patmakesapps/humalien/exports/plate3/forehead_casing_x1.stl

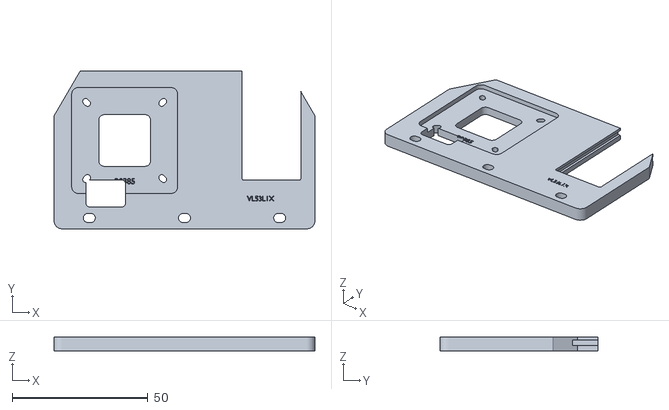
[picture p1: CAD file, 2026-08-13]
exports/plate3/forehead_casing_x1.stl
96.0 x 58.0 x 5.00
