patmakesapps/humalien/exports/plate4/ear_hub_l_x1.stl

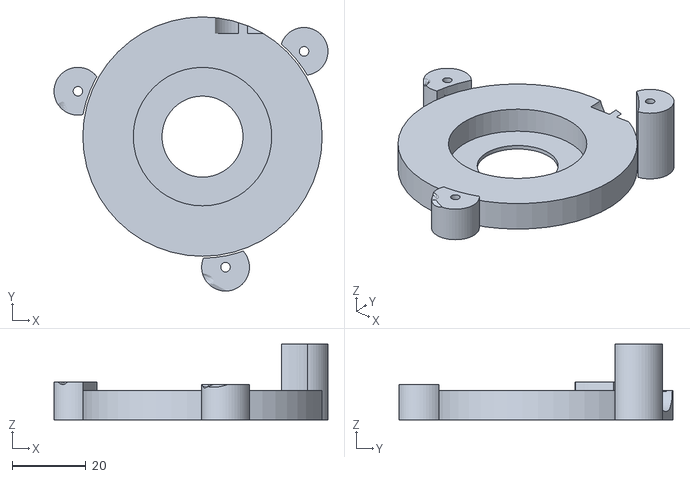
[picture p2: CAD file, 2026-08-14]
exports/plate4/ear_hub_l_x1.stl
74.4 x 74.5 x 20.6
