patmakesapps/humalien/exports/plate3/pca9685_mount_x1.stl

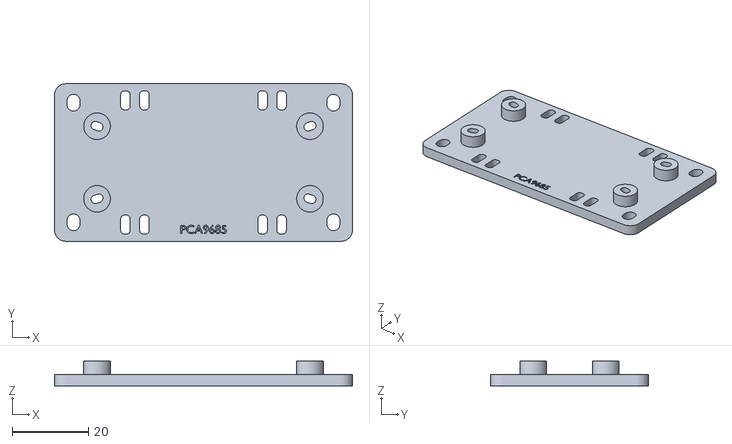
[picture p3: CAD file, 2026-08-13]
exports/plate3/pca9685_mount_x1.stl
78.2 x 41.4 x 6.50
