patmakesapps/humalien/(list of files, cad)

Other CAD files:
exports/plate4/ear_hub_r_x1.stl
