patmakesapps/humalien/cad/head_mounts.py

"""Give every part in the head something to bolt to, and build the parts the
head itself needs.

Run inside Blender AFTER head_style.py has built HEAD_CYBORG and HEAD_SKIN,
and after fit_layout.py has placed FIT_Assembly. head_style.py must have been
exec'd into the same namespace, because `S` and `eye_axis` come from it:

    ns = {}
    for f in ("head_style", "head_mounts"):
        exec(compile(open(r"C:\\humalien\\humalien\\cad\\%s.py" % f).read(),
                     f, "exec"), ns)
        ns["build"]() if f == "head_style" else ns["build"](ns["S"],
                                                            ns["eye_axis"])

Before this pass every part in the fit study was floating. The layout was
honest about it - "the skull-side fixings on the parts are slotted precisely
because these numbers are guesswork until a head shell exists" - but a head
shell exists now, so the guessing is over.

The rule this file follows
--------------------------

**A screw is only worth drawing if a hand can reach it.** That one test
decides most of what follows, and it is why head_split.py exists: with the
face off, the cranium is an open bowl and every fixing below is reachable
from the front. Nothing here asks a screwdriver to turn a corner.

Two patterns, and the choice between them is about which side of the skin
the hand is on:

    boss      A post standing on the shell's inner surface, reaching out to
              meet the part's own mounting face; the screw goes in from the
              part's side. Used where the part is near a wall and the inside
              is open - the PCA9685 on the rear wall, the cable anchors, the
              forehead casing off the brow.

    through   A clearance hole in the skin, with the part behind it carrying
              the thread, so the screw head sits on the outside of the head.
              Used where a part cannot be reached from inside once fitted -
              the ear hubs, the tray rails. Visible fasteners are not a
              compromise: every reference photo is covered in them.

No boss length is guessed. Each is raycast from the part's fixing point to
the shell's inner surface, so the post is exactly as long as the gap it
crosses, and a re-run after a styling change re-measures instead of
re-guessing. The same trick shapes parts: build a lug deliberately too long,
subtract the head, and it comes back trimmed to the skin's curvature.

The parts this file builds
--------------------------

`ear_hub`       The port module the fit study left as PROXY_ear_hub_TBD: a
                Ø65 plug carrying the NeoPixel ring in a recess, the grille
                through its middle, the speaker on two posts behind it, and
                three arms reaching out to the shell.

                It fits from INSIDE, and it has to. The head's surface around
                the ear varies by 20 mm in depth across the Ø66 port, so
                there is no flat collar that could ever sit on that skin; and
                any arm long enough to reach the shell is wider than the bore
                it would have to pass through. Once the head splits, fitting
                from inside costs nothing - the cranium is an open bowl.

`eye_bezel`     Closes the 4.5 mm annulus between the Ø41 socket and the Ø32
                eyeball. Without it the eye reads as a ball dropped down a
                hole; with it, as an eye in a socket. Its front face is set
                from the shallowest point on the socket rim, measured, since
                the skin over the socket is not flat.

                A removable forehead panel was built here too and then
                deleted. The reasoning is kept in head_style.S under
                `brow_band`: the forehead drops 20 mm from the centreline to
                the temple across the width that panel wanted, and on a
                surface that steep its landing pads sit behind the skin in
                the middle and break out through it at the edges. The brow
                band is a groove now, and the camera is serviced by taking
                the face off, which is four screws either way.

`tray_rail`     A ledge each side for the Pi 5 tray. The tray's four slotted
                fixings sound like four bosses and cannot be: at tray height
                the skull is 120 mm across and the nearest floor is 100 mm
                below, so a post under a corner would be a 100 mm spike.
                Ledges off the side walls are what the geometry allows,
                and eye_mech's pi5_tray gained four side fixings to land on
                them.

Booleans are batched and baked: everything being added to the shell is
joined and unioned once, everything being cut is joined and subtracted once,
and the file saves between stages. A live stack of booleans over this sculpt
has taken Blender down before. They run on the MANIFOLD solver - see
`boolean` for the three separate ways EXACT failed on this shell.

Two traps in here cost more time than the geometry did, and both are silent:
a boolean whose cutter object the depsgraph has not seen evaluates against
nothing, and a boolean on an object in a hidden collection bakes the mesh it
already had. Neither raises. `_bake` and `_ensure_evaluable` exist for them.
"""

import bpy
import bmesh
import math
from mathutils import Matrix, Vector
from mathutils.bvhtree import BVHTree

COLL = "MOUNT_Parts"
HEAD = "HEAD_CYBORG"
SKIN = "HEAD_SKIN"
SOLID = "HEAD_SOLID"    # closed volume of the head; nothing may leave it
ZONE = "MOUNT_ZONE"     # where mount geometry is allowed to exist
ZONE_INSET = 1.5        # mm below the outer skin the zone stops
ARM_MIN = 6.0           # mm of reach below which an arm is a stub, not a boss
# The root flare under each ear-hub boss. Ø23 down to Ø13 over 5.0 mm is a
# 45 degree wall - self-supporting - and it takes the bonded cross-section
# where the boss meets the Ø65 plug from 21.5 mm2 to 116.3 mm2. 5.0 is under
# plug_t, so the flare stays inside the plug's own thickness and can never
# reach the front face, show in the ear port, or foul the NeoPixel ring.
# Ø23 is set by the 15.75 mm from the 290 degree boss to the z-24 blind
# thread, not by taste. See cad/ear_hub_repair.py for the measurements.
ARM_FLARE_D = 23.0
ARM_FLARE_H = 5.0

M = dict(
    m3_free   = 3.4,      # clearance for an M3
    m3_pilot  = 2.6,      # self-tapping pilot in PLA for an M3
    m2_pilot  = 1.7,
    boss_d    = 10.0,
    wall      = 4.0,

    ear       = dict(y=95.0, z=204.0, bore=66.0,
                     plug_d=65.0,        # 0.5 clearance in the Ø66 bore
                     plug_t=8.0,
                     face_x=47.5,        # outer face, behind the deepest rim
                     ring_od=37.6,       # 36.83 + fit
                     ring_t=6.9,         # 6.7 + fit
                     grille=22.0,        # aperture under the ring's Ø23.4 ID
                     arm_r=36.0,         # screw circle, outside the Ø66 bore
                     arm_d=13.0,
                     # deg, 0 = +y. NOT (90, 210, 330), which was wrong twice
                     # over. Measured at r=36 from the arm root plane x=39.5,
                     # the skull leaves: 90 deg 23.2 mm, 330 deg 16.7 mm, and
                     # 210 deg 2.6 mm. 2.6 mm is not a boss. It built as a
                     # 0.07 mm disc buried in the wall - 72 verts of it inside
                     # the shell, with an M3 pilot drilled into nothing - and
                     # that is the lump that reads as a boss smashed into the
                     # head on both ears. The whole lower-rear quadrant is
                     # dead: 190-260 deg all measure under 6 mm because the
                     # skull closes on the hub's back plane there.
                     # 90 deg was separately wrong: spk_pitch/2 is also 36, so
                     # the +z speaker post sat on that exact axis (0.000 mm
                     # apart) and both pilots were drilled down it.
                     # (50, 170, 290) is the only clean answer - an exact
                     # 120 deg pattern, every arm >= 19.2 deg clear of both
                     # speaker posts, bosses 20.6 / 9.6 / 10.3 mm.
                     arm_a=(50.0, 170.0, 290.0),
                     spk_pitch=72.0,     # LISTING - flange holes unmeasured
                     spk_post=6.0,
                     # The two screws holding the spine onto the back of the
                     # plug, at y=ear y and z=ear z +/- this. 24 keeps them
                     # outside the Ø37.6 ring recess (r=18.8, which leaves only
                     # 1.1 mm of plug behind it) and 12 mm clear of the speaker
                     # posts at +/-36. Anywhere between about 21 and 30 works.
                     join_dz=24.0,
                     # 90 tall put the spine's top edge 1.00 mm under the
                     # tray rail. 80 gives 6 and still spans the speaker's
                     # 72 mm flange pitch with 4 mm each end.
                     spine=(16.0, 80.0, 4.0)),

    # idia was 33.6, which measured 1.29 mm from the eyeball at its closest -
    # no intersection, but too close to look right and too close to trust
    # once there is a real gimbal in there instead of a perfect sphere.
    # 35.6 puts 2.3 mm all round and still closes most of the 4.5 mm annulus
    # the Ø41 socket leaves around a Ø32 ball.
    eye       = dict(pitch=62.0, y=160.0, z=209.0, socket=41.0,
                     od=39.6, idia=35.6, t=6.0, ball=32.0, recess=1.5),

    # The eye mechanism's bulkhead. y is the BACK face; 134 front puts it
    # 1 mm behind the y=135 split, so it lives in the cranium.
    eye_plate = dict(y=128.0, t=6.0, w=140.0, z0=178.0, z1=240.0,
                     bore=30.0,
                     grid_x=(-40.0, -20.0, 0.0, 20.0, 40.0),
                     grid_z=(186.0, 206.0, 226.0),
                     screw_z=(188.0, 232.0)),

    # Pi 5 tray: plate z 256..259, slots at (0,131.5) (0,48.5) (+-27, 90)
    tray      = dict(z=256.0, slot_x=27.0, slot_y=(60.0, 120.0),
                     rail_y0=54.0, rail_y1=126.0, rail_t=6.0, rail_x0=22.0,
                     screw_y=(70.0, 110.0)),
)

# Every fixing that gets a boss: (label, world point on the part's mounting
# face, unit direction from that point towards the shell, screw size).
#
# forehead_casing  three slots along the plate's bottom strip, front face
#                  y=167; posts run forward to the brow and the screw goes
#                  in from behind, which is open once the face is off
# pca9685_mount    four corner slots, back face y=42, posts back to the rear
#                  wall. That wall bows 13 mm across the plate, which is
#                  exactly why these are measured one by one
# cable_anchor     two on the rear wall, two on the side walls
#
# `lift` raises the point the ray is fired from without moving the screw.
# The casing's two outer fixings sit at z=229 and the Ø41 eye socket reaches
# z=229.5, so at x=±35 a ray fired forward leaves through the eye opening and
# finds no shell at all. Fired 4 mm higher it lands on the brow, and a Ø15
# post still puts 6 mm of material around a pilot drilled at the true
# height. The alternative was raising the whole casing 2 mm, which spends
# the brow clearance that was just bought back.
BOSSES = [
    ("casing_R",   Vector(( 35.0, 167.0, 229.0)), Vector((0, 1, 0)),  "m3",
     dict(lift=Vector((0, 0, 4.0)), dia=15.0)),
    ("casing_C",   Vector((  0.0, 167.0, 229.0)), Vector((0, 1, 0)),  "m3", {}),
    ("casing_L",   Vector((-35.0, 167.0, 229.0)), Vector((0, 1, 0)),  "m3",
     dict(lift=Vector((0, 0, 4.0)), dia=15.0)),
    ("pca_RT",     Vector(( 34.1,  44.0, 245.7)), Vector((0, -1, 0)), "m3", {}),
    ("pca_LT",     Vector((-34.1,  44.0, 245.7)), Vector((0, -1, 0)), "m3", {}),
    ("pca_RB",     Vector(( 34.1,  44.0, 214.3)), Vector((0, -1, 0)), "m3", {}),
    ("pca_LB",     Vector((-34.1,  44.0, 214.3)), Vector((0, -1, 0)), "m3", {}),
    ("anchor_1",   Vector((  7.6,  35.0, 240.0)), Vector((0, -1, 0)), "m2", {}),
    ("anchor_2",   Vector(( -7.6,  35.0, 240.0)), Vector((0, -1, 0)), "m2", {}),
    # Dropped from z=164.4 to z=146.4. At the old height these two sat
    # exactly where the ear hub's speaker spine now runs (x 35.5..39.5,
    # z 159..249) and the two parts shared 1.5 mm of the same space.
    ("anchor_3",   Vector(( 38.0,  92.0, 146.4)), Vector((1, 0, 0)),  "m2", {}),
    ("anchor_4",   Vector((-38.0,  92.0, 146.4)), Vector((-1, 0, 0)), "m2", {}),
]
# The tray's own front and rear fixings, at (0, 131.5) and (0, 48.5), get
# nothing. There is no wall behind the rear one - that is where the cranial
# opening is - and the shell in front of the other one is the forehead,
# 62 mm away. The tray hangs off its four side fixings on the two rails
# instead, which is why eye_mech.pi5_tray gained four of them.

COL_MOUNT = (0.85, 0.45, 0.10, 1.0)
COL_HUB = (0.10, 0.10, 0.12, 1.0)


# ---------------------------------------------------------------------------
# primitives - all append into a caller-owned bmesh, so a whole batch of
# added or removed geometry ends up as one object and one boolean
# ---------------------------------------------------------------------------
def _mesh(name, bm):
    bmesh.ops.recalc_face_normals(bm, faces=bm.faces[:])
    me = bpy.data.meshes.new(name)
    bm.to_mesh(me)
    bm.free()
    return me


def _link(coll, name, me, color=COL_MOUNT):
    ob = bpy.data.objects.new(name, me)
    ob.color = color
    coll.objects.link(ob)
    return ob


def _merge(bm, tmp):
    me = bpy.data.meshes.new("_t")
    tmp.to_mesh(me)
    tmp.free()
    bm.from_mesh(me)
    bpy.data.meshes.remove(me)
    return bm
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
