patmakesapps/humalien/(commit log)

2026-08-12 Add Raspberry Pi hardware node
2026-08-12 document vision alongside the voice pipeline
    The face tracking commit added code and vision.md but left the
    surrounding docs behind.
    - hardware.md: webcam and servos in the parts table, opencv install
    step, camera index selection, and the open question of whether the
    camera ends up on the brain or the Pi
    - architecture.md: vision data flow, and rewrite "what's not built yet"
    around the two signals now waiting on servos
    - README.md: camera in the diagram, pip install step, all three test
    files with counts
    Also record why a jaw must be driven from PacedPlayback.is_speaking
    rather than response.output_audio.delta: the API delivers audio ~10x
    faster than it plays, so delta events descr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
2026-08-12 detect profile faces and point the jaw hook at playback
    Tracking held straight on but dropped as soon as a head turned side
    on. The frontal Haar cascade is a frontal detector, so that is by
    design rather than a tuning problem.
    Try the frontal cascade first, since a face looking at the robot is
    both the common case and the most reliable detection. Fall back to the
    profile cascade, then to the profile cascade on a horizontally flipped
    frame, since it is trained on one direction only. FaceBox.mirrored
    flips those coordinates back.
    This improves profile tracking without making it good: neither cascade
    fires reliably through roughly the three-quarter view. docs/vision.md
    records that dead zone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
2026-08-12 recognise people, remember them, and look on request
    Identity is an embedding problem, not a language problem. A small model
    asked "is this Patrick?" is slow, costs a call every time, and is
    confidently wrong in the way that matters. SFace turns a face into a
    128-d unit vector and recognition becomes a dot product, so it runs
    continuously for ~15 ms of CPU and no tokens. That substitution is what
    removes the need to gate a language model in the hot path at all.
    Detection moves from the Haar cascade chain to YuNet, for two
    independent reasons: it handles head rotation as a continuum rather
    than discrete poses, removing the three-quarter dead zone, and it emits
    the five landmarks SFace needs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
2026-08-12 stop near misses from enrolling as strangers
    First live session with two faces. Recognition itself held up well:
    0.79-0.88 for the same person, ~0.28 between two different people, and
    279 sightings landing in one record rather than fragmenting.
    But it also produced five orphan records. One scored 0.383 against a
    known person - that is the same face caught mid-turn, falling just
    under MATCH_THRESHOLD and being enrolled as a stranger.
    Add an ambiguous band between CREATE_BELOW (0.30) and MATCH_THRESHOLD
    (0.40). A face in that range is neither matched nor enrolled;
    perception waits for a cleaner look. Strangers at 0.28 still enroll, so
    the guard does not block real people. Fitted to one sessi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
2026-08-12 one robot: give the conversation eyes and a memory
    Voice and vision were two programs that had never met. This wires them
    into one.
    eyes.py runs capture and recognition on a worker thread beside the
    conversation, publishing the latest frame and sightings rather than
    making anyone wait for them. A camera that fails to open logs and
    blocks forever instead of returning, because losing the eyes must not
    take the conversation down with it.
    Three tools on the session. who_is_here is free and instant, so the
    model can always find out who it is talking to. remember_name writes
    immediately, because the rest of the conversation depends on knowing
    it. look costs a call and about eight seconds, so the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
2026-08-12 document what must not be installed on the Pi
    git pull brings the whole repo to both machines, so it is easy to cd
    into brain on the Pi out of habit and drag OpenCV onto a machine that
    never opens a camera.
    The node needs websockets and alsa-utils. Nothing else. It imports
    nothing from brain, and that one-package dependency list is what makes
    "the node is a dumb pipe" a testable claim rather than an aspiration.
    Called out separately: the Pi should hold no .env and therefore no
    OpenAI API key. It is the machine physically inside a robot that could
    be knocked over, handed to somebody, or lost, and it has no need of
    credentials.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
2026-08-12 handle mono devices and say which device is wrong
    The desktop simulator hardcoded stereo capture, so a mono microphone
    failed with PortAudio's "Invalid number of channels [-9998]", which
    says nothing about which device or why.
    usable_channels now queries the device and reports plainly when it has
    no channels in the direction asked for. That immediately surfaced the
    real problem in testing: the configured input device was a Headset
    Earphone, an output, so the error was never about channel counts at
    all.
    The wire protocol stays 48 kHz stereo, because that is what the
    Waveshare hat produces and what the brain expects. The simulator
    converts locally instead - duplicating a mono capture, foldin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
2026-08-12 move the vibe out of code and into persona.md
    gpt-realtime has no separate voice or vibe parameter - the openai.fm
    demo is the TTS API, which does. For speech-to-speech, accent, pacing,
    tone and personality are all steered through session instructions.
    That makes the vibe writing, not logic, so it should not live in a
    Python string constant. persona.md holds it now, loaded at startup,
    with HUMALIEN_PERSONA to point at a different file and swap the
    character wholesale. A missing file falls back to a minimal built-in
    rather than starting with no character at all.
    Added the delivery direction the instructions were missing. They
    covered what to say and never how it should sound: pace, warmth,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
2026-08-12 tidy the env template
    HUMALIEN_CAMERA appeared twice in .env.example, and the desktop
    simulator section did not mention that HUMALIEN_PI_URL has to point at
    localhost while using it - which is what led to the URL being set twice
    in a real .env, where only the last one takes effect.
    Regrouped into connection, conversation, character, eyes, and desktop
    simulator, with one entry per key.
    Claude-Session: https://claude.ai/code/session_01BdFwjgisrDRQ25hsa1N9U6
2026-08-12 document the duplicate HUMALIEN_PI_URL trap
    The desktop simulator needs a different HUMALIEN_PI_URL from the
    default, so it is natural to add a second line rather than change the
    first. .env is last-value-wins, which means the bottom one silently
    decides and editing the top one does nothing. The failure looks exactly
    like a network fault while the file plainly states the right address.
    running.md now covers switching between the laptop and the Pi, with a
    grep to check for a second definition when a connection failure makes
    no sense. hardware.md warns at the point where the simulator asks you
    to change the value, and also notes that setting an output device as
    the input surfaces as PortAudio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
2026-08-12 stop it narrating tool results
    Saying "Hello?" got back "there's someone new in view. I don't
    recognize them yet..." - the model reading its who_is_here result
    aloud. The persona said not to narrate the private notes pushed into
    the conversation, but a tool result arrives on a different channel and
    was being treated as something to report.
    The rule is now about perception rather than about notes: what you see,
    who you recognise, and anything you look up is your own head, not
    conversation. With the specific phrasings it kept producing named as
    things never to say, and the blunt case spelled out - if somebody says
    hi, say hi back, that is the whole reply.
    It also called a tool at all on a ba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
2026-08-12 look at the moment the question was asked, not the moment it lands
    Asking "how many fingers am I holding up" got back "the hand is
    blurred". The frame was fine; the timing was not. look read whatever
    the camera saw at that instant, which is two to four seconds after the
    question started - speech has to end, VAD has to fire, the model has to
    generate a sentence, and only then does the tool call arrive. The hand
    has moved.
    eyes.py now keeps a few seconds of downscaled frames with a sharpness
    score each, and look asks for the clearest one from the window the
    person was actually speaking in. speech_started_at and
    speech_stopped_at were already arriving and being logged and discarded.
    Sharpest r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
2026-08-12 write up the physical build plan
    Power, servos, sensors and skin, plus the reasoning for building eyes
    before the neck.
    Eyes first is not about difficulty. gaze.py has produced smoothed
    normalized targets since the first vision commit and nothing consumes
    them, so eyes turn a tested contract into something that moves. More
    usefully, they are the cheapest way to find out whether 4 Hz
    recognition and a 0.12 s smoothing constant read as alive or as a
    twitching machine - which the code cannot answer. Any tuning that falls
    out applies to the neck later, and the whole motion stack gets
    de-risked where a mistake costs a four pound servo.
    The thing that cannot wait is head weight, since it sets ne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
2026-08-12 add a parts list
    Records what is in hand, what is decided, and what is still planned,
    with the I2C address map so bus conflicts surface before anything is
    wired.
    Notes the two connector families already in play: the SHT41 is STEMMA
    QT with two sockets so it can daisy-chain, while the VL53L1X ships with
    a plain six-wire cable, and the Pi 5 has no Qwiic socket at all.
    Flags that B0332 is the monochrome sensor. It is cheaper and faster and
    useless here, since answering what colour something is was the reason
    for having a camera at all.
    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
2026-08-12 record what was actually ordered for eye motion
    The five parts for making eyes move, with the specific items chosen,
    plus the wiring in full. The screw terminal turned out to ship with the
    power supply, so it dropped off the list.
    Notes the Jetson reality: $249 was the announcement price, NVIDIA's own
    marketplace lists $399, and resellers were asking $769 against real
    scarcity. Nothing is blocked on it, so it moved to a buy-when-sane
    section rather than a shopping list.
    Records the deviation from Cogley's reference mechanism. The left pupil
    takes the VL53L1X so distance is measured to whatever Humalien is
    looking at, the right eye stays a plain eyeball, and the camera goes in
    the forehead.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
2026-08-12 camera ordered
    Arducam B0385, the OV9782 colour sensor. Moved to the ordered list,
    with the note about B0332 looking near-identical in listings kept where
    it is still useful.
    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
2026-08-13 record what was actually ordered
    Capacitor swapped to Rubycon low-ESR, same 1000uF 25V spec. Order number,
    real total and delivery split noted, plus the fact that the capacitor is not
    needed for a first single-servo sweep.
    Claude-Session: https://claude.ai/code/session_011h71P79XNBAeDHwGmUHMkE
2026-08-13 confirm the power supply needs no soldering
    The ALITOVE ships with the screw-terminal adapter, so the only soldering in
    the eye build is the PCA9685 headers.
    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
2026-08-13 drop leaded solder, note lead-free technique
    Going without 63/37, so the optional-purchase line is gone and the technique
    that actually matters for lead-free is written down instead. Also swaps the
    freed row in Next to buy for the Qwiic adapter the I2C section already implies,
    and corrects the Jetson comparison to the real $399.
    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
2026-08-13 add a brief for the custom eye mechanism
    The bespoke design differs from every reference online in one way that drives
    everything: a distance sensor inside a moving eyeball. Writes down the
    constraints that follow from that, and separates the work that can start now
    from the work that depends on answers the reference build will give.
    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
2026-08-13 source dimensions from datasheets, prove them with fit coupons
    There are no calipers in this build, so dimensions come from manufacturer
    mechanical drawings with the URL recorded alongside, interfaces get slotted
    holes and deliberate clearance, and a printed test coupon verifies each hole
    pattern before the real part is committed to.
    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
2026-08-13 treat the reference mechanism as a measuring tool
    The brief named Cogley'''s mechanism without saying where it comes from or what
    to do with it. It is free geometry from MakerWorld that opens in Bambu Studio,
    and importing it into Blender gives servo pockets and linkage spacing that have
    been printed and proven — a better source than a nominal datasheet envelope for
    a build with no calipers. Notes the licence question that comes with deriving
    from it.
    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
2026-08-13 point at the reference mechanism without redistributing it
    The 3mf is Cogley'''s work, so it stays git-ignored and gets downloaded per
    machine. Records which of the five plates to print: the download ships SG90 and
    MG90s variants, and this build uses MG90S, so two plates get deleted rather
    than wasting half the print time on parts the servos will not fit.
    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
2026-08-13 Source dimensions, then cut only what they support
    Dimensions first, per the brief. Every number now carries where it came from,
    and the confidence level is data rather than commentary: CONF_PAD in
    cad/eye_mech.py turns a listing-grade source into +1 mm of slop automatically.
    PCA9685 came out exact - Adafruit publish the Eagle board file, so the outline
    and hole pattern were parsed rather than read off a drawing. 62.230 x 25.400,
    four 2.5 mm holes at 55.880 x 19.050. The fab print is dimensioned in inches
    and easy to misread; the board file cost less effort and settles it.
    B0385 from Arducam's datasheet drawing. Worth knowing: the connector is a 4-pin
    JST S4B-ZR, not a USB socket, and the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
    [cable_anchor_x6.stl, camera_boss_x1.stl, coupon_b0385_x1.stl, coupon_mg90s_x1.stl, coupon_pca9685_x1.stl, coupon_vl53l1x_x1.stl, pca9685_mount_x1.stl]
2026-08-13 Settle the VL53L1X off a holder that already works
    The weakest row in the dimensions table is now the best-sourced one. CQRobot's
    wiki and product page are both 404 and the surviving listings disagreed -
    28.5x23 against 26x23 - so it was settled by measuring a CQRobot holder already
    in service on two robots: LumaBot V2, 04_distance_sensor_mount.
    Its retention slot is 23.600 x 29.100 x 2.100. The +0.6 fit that mount uses is
    the only clearance putting both axes on round numbers, and the pair it gives -
    23.0 x 28.5 x 1.6 - matches one of the two competing listings exactly. The 26 mm
    listings are wrong. A part that has held the real board twice beats a datasheet
    that does not exist.
    The holder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
    [cable_anchor_x6.stl, camera_boss_x1.stl, coupon_mg90s_x1.stl, coupon_vl53l1x_x1.stl, pca9685_mount_x1.stl]
2026-08-13 Move the ToF to the forehead, light the eyes instead
    Decision recorded: the CQRobot board goes in the forehead beside the camera.
    That gives up distance-to-whatever-it-is-looking-at, which was the one thing
    making the left eye different from every reference mechanism online - range and
    gaze now decouple. Worth saying plainly rather than glossing. In exchange it
    costs nothing and buys no parts, and hardware.md already argued the distance
    sensor wants to look where the face looks.
    tof_mount copies the retention that already works: the board slides into a slot
    and is trapped by a lip, no screws. Kept as its own part rather than merged into
    the camera plate, because where those two sit relative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
    [cable_anchor_x6.stl, camera_boss_x1.stl, coupon_neopixel12_x1.stl, pca9685_mount_x1.stl, tof_mount_x1.stl]
2026-08-13 Make the head subordinate to the parts
    Was about to derive interpupillary distance by measuring the head mesh, which
    is backwards. The mesh is a styling surface that gets remodelled into a cyborg
    head around the mechanism; it is not a source of dimensions the mechanism then
    has to honour. eye_pitch is a design parameter and the sockets move to suit it.
    Recorded the envelope the head actually has to swallow instead - about 100 mm
    across for two Ø32 eyeballs and their static Ø36.83 rings at 62 mm pitch, and
    185 mm front to back. That is the check to repeat whenever the head is
    restyled: not whether it looks right, but whether 100 x 185 is still there.
    If styling ever costs that, styling los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
2026-08-13 Put the camera and distance sensor in one row on one plate
    forehead_casing replaces the separate camera_boss and tof_mount. Both apertures
    now sit on a single horizontal centreline 56.2 mm apart, verified by section:
    camera window and sensor window both centred at y=3.500.
    The earlier split was justified on the grounds that where the two sat relative
    to each other was a skull question. That was wrong. Two brackets is two chances
    to be out of line, and alignment between a camera and a rangefinder that are
    supposed to describe the same scene should be a property of the geometry, not
    something to get right at assembly.
    It costs nothing to guarantee. The B0385 sensor is dead centre on its boar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
    [cable_anchor_x6.stl, camera_boss_x1.stl, forehead_casing_x1.stl, pca9685_mount_x1.stl, tof_mount_x1.stl]
2026-08-13 Load the sensor downwards so it needs no screws
    Three faults, all caught from photographs of the real parts before anything was
    printed.
    The sensor would have hung there. The channel ran off the outboard edge, so the
    board slid in sideways with nothing whatever to stop it sliding back out. Now it
    is a U: open at the top to load, closed at the bottom by an 18 mm shelf.
    Which way it loads is not a detail, it is what removes the fastener. Dropped in
    downwards, gravity holds the board on the shelf and nothing else is needed. Up
    or sideways and gravity works to eject it, so a screw becomes mandatory - and
    there is nowhere trustworthy to put one, since the board's mounting hole
    positions are unk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
    [cable_anchor_x6.stl, forehead_casing_x1.stl, pca9685_mount_x1.stl]
2026-08-13 Take the sensor slot from the holder instead of deriving it
    Compared the channel against the LumaBot mount properly, and three of the five
    numbers were wrong. The slot thickness had been derived as board nominal plus a
    guess - 1.6 + 0.2 = 1.800 - where the holder that actually works measures 2.100.
    That 0.3 is the difference between a board that slides in and one that does not,
    and it is exactly the kind of number a nominal cannot tell you.
    proven was now
    groove face to face 23.600 23.600 23.600
    PCB groove thickness 2.100 1.800 2.100
    groove depth per side 1.000 1.500 1.000
    opening between walls 21.600 20.600 21.600
    groove height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
    [forehead_casing_x1.stl]
2026-08-13 Add a tray for the Pi 5, park the X1200
    pi5_tray, off Raspberry Pi's own mechanical drawing: 85 x 56 board, four 2.7
    holes on a 58 x 49 pattern, 3.5 mm in from one long and one short edge.
    The pattern is not centred on the board - its centre sits 10.0 mm off the board
    centre along the length. Assume it is centred and every hole is out by 10 mm,
    which stays invisible until the board will not drop on. Verified after building:
    holes at (-39, +/-24.5) and (19, +/-24.5).
    Board holes are round, not slotted. The slotting policy is for dimensions that
    have not been verified; this one is from the manufacturer's own drawing and the
    board in hand is a genuine Pi, so there is nothing to take up and sl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
    [cable_anchor_x6.stl, pca9685_mount_x1.stl, pi5_tray_x1.stl]
2026-08-13 Record what to believe in the LumaBot file, put the speakers behind the ears
    The LumaBot model has known-bad hole depths and sizes but correct dimensions, so
    which half was used matters. Everything taken from it is slot geometry - groove
    faces, groove depth, groove thickness, groove height - and not one screw hole,
    which puts all of it on the trustworthy side. Its fastener schedule was never
    used; the M3 fixings on these parts are our own slotted holes. Written into the
    brief so the next person opening that file for reference knows which half to
    believe.
    Speakers decided: one behind each ear. Furthest from a centre-mounted mic pair,
    closest to where a head actually radiates sound, and each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
2026-08-13 Place every part inside the head, and start cutting the cyborg into it
    cad/fit_layout.py builds FIT_Assembly: the printed parts as linked
    duplicates at their working positions, board proxies from the same
    numbers BOARDS carries, and a self-check that ray-casts every part
    against the skin - known head-remodelling debts whitelisted so a layout
    regression cannot hide among them.
    The study found where the head must serve the parts: the scan's sockets
    sit at pitch 56 against the design 62, the brow flanks are too curved
    for the casing's top corners by 10 mm, and the rings need bezels. All
    three recorded as styling debts, not part changes.
    cad/head_style.py begins that styling non-destructively: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
2026-08-13 Light the eyes from within, hang the rings in the ear ports, raise a visor
    The glow moves inside the eyeball: one 5050 pixel per eye behind a
    translucent printed iris, so the light tracks the pupil at every gaze
    angle. That reopens wires across the eye joint - 4 left, 3 right - which
    is exactly the load the left-eye wiring plan carried before the ToF moved
    to the forehead. The rings, already shipping, recess into the Ø66 ear
    ports framing the speaker grilles, and bench-test the Pi 5 WS2812 chain
    first. The ring-bezel debt dies with the cause removed.
    The brow gets a visor band instead of a part rev: the corner chamfer was
    written and reverted - parts stay stock, styling does the work, per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
    [head_style.py]
2026-08-13 Ditch the visor, keep the silhouette; clean sockets, seat the ear rings
    Re-read the reference photos: all three keep a smooth human silhouette
    and get their cyborg from seams, hubs and openings - never added volume.
    The visor band goes. The casing corners vs the brow flanks become an
    honest open debt, with both candidate fixes parameterized and off: the
    part chamfer (written and reverted twice, part stays stock) and the
    flank swell (amp=0).
    The eye sockets come out clean: the copy step now pre-deletes the lash
    cards and lid shells within r=19 of each eye axis - zero-thickness
    strips no boolean can remove - so the Ø41 cut lands on simple surface.
    The mouth-bag interior goes the same way, fo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
    [head_style.py]
2026-08-13 Empty the mouth, cut the bust off, and give the brow its band
    The sculpt's mouth was a tongue, gums and a throat bag sitting in the middle
    of the skull - 8800 faces of filament and volume where the electronics go.
    The previous pass looked for it with a ray-parity test and found almost
    none of it, because parity is the wrong question: the lips are parted, so
    the cavity is formally outside and parity votes to keep it. The question is
    whether a face can see the sky. Forty-two rays per face, delete anything
    that escapes in under 5% of directions, and the mouth bag, the nostril
    cavities, the ear canals and the eyelid interiors all go under one rule
    with no boxes to draw.
    The bust went too. Cutti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
    [head_style.py]
2026-08-13 Empty the head, then give everything in it something to bolt to
    Four things, and the first one is the reason for the other three: the sculpt
    was carrying geometry nobody would ever see and every part inside it was
    floating in mid air.
    The mouth was a tongue, gums and a throat bag - 8800 faces of filament and
    volume sitting exactly where the electronics go. The previous pass hunted it
    with a ray-parity test and found almost none of it, because parity is the
    wrong question: the lips are parted, so the cavity is formally outside the
    skin and parity votes to keep it. The right question is whether a face can
    see the sky. Forty-two rays per face, delete anything that escapes in under
    5% of direct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
    [head_mounts.py, head_split.py, head_style.py]
2026-08-13 Ask the other question: do the parts pass through each other
    verify() has been the only check in this project and it asks exactly one
    thing - is this part inside the skin - and it has answered correctly every
    time. Nobody had asked whether the parts pass through EACH OTHER. While
    verify() reported CLEAN, the eye bezel ran through the forehead casing, two
    cable anchors ran through the ear hubs, and every boss in the head pushed
    1.5 mm into the part it was meant to be holding. It took someone looking at
    the screen to catch it.
    fit_layout.collide() asks it now. Touching is not a fault - a board sits on
    its standoffs, a tray on its rails, a ring in its recess - so CONTACT names
    the pairs where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
    [head_mounts.py]
2026-08-13 Stop the bosses coming out through the skin, and the fins with them
    Every one of the eleven mount bosses was breaking out through the head. The
    casing pair stood 6.6 mm proud, the PCA bosses 5.3, the cable anchors 3.8.
    The cause was a bad decision one layer up: each boss was sized by casting a
    single ray down its own centreline to find the wall, and then built as a
    flat-ended cylinder. On a curved skull a ray down the middle reports 19 mm of
    clearance while the cylinder's rim is already outside the bone. No amount of
    adjusting that number fixes it - shortening the boss to protect the rim just
    stops the middle reaching the wall at all. A flat end cannot meet a curved
    wall, and measuring it m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
    [head_mounts.py, head_style.py]
2026-08-13 Stop the part editors rotting the parts they edit
    pi5_tray was at 2.2 MILLION vertices with 55 non-manifold edges. Still the
    right 93 x 64 x 8 shape, and completely unprintable.
    tray_side_slots and casing_chamfer cut the persistent part object rather than
    rebuilding it, so neither is idempotent. Run the pipeline twice and the same
    four slots get cut into an already-slotted mesh. A coincident boolean cut
    does not no-op - it sheds degenerate geometry - and about ten re-runs took
    the tray from 2345 vertices to 2.2 million. forehead_casing was creeping the
    same way, 2395 to 2633. Nothing warned. The parts just quietly rotted while
    every check I had went on reporting the head clean, because none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
2026-08-13 Clip mount geometry to where it is allowed to be, not to the whole head
    Three of the things visible on screen were one mistake: clipping mount
    geometry against HEAD_SOLID. That object is the wrong shape for the job in
    two ways.
    It stops at the outer skin, so a boss clipped against it eats the whole 4 mm
    wall and its end face IS the outside of the head - not protruding, but welded
    into the skin, which is the circular scar of dense topology above each eye.
    And its holes are filled, because it is built from the skin before the
    openings are cut, so it does nothing to stop a boss walking straight into an
    opening - which is why one was standing in the middle of the ear port.
    MOUNT_ZONE is HEAD_S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
    [head_mounts.py]
2026-08-13 Open the brow for the casing, and lay v1 out to print
    The forehead casing is 96 mm wide and the brow at that height is about 76,
    so both of its top corners were buried in the shell wall - measured, the
    plate front at y=167 breaks the inner wall from |x|>=48 at z=254 tightening
    to |x|>=34 at z=284. Three ways out were on the table: move the casing back
    7 mm and spend camera FOV, narrow the plate and re-space both apertures, or
    open the head where the plate has to pass. Third one, by choice: the open
    look is wanted, and it is easier and safer to work on during development.
    A matched PAIR of brow ports at |x| 20..53, z 242..288 replaces the separate
    Ø16 camera bore and the small ToF window. E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
    [head_mounts.py, head_style.py]
2026-08-13 Give the eyes something to bolt to, and retire the sensor-in-the-eyeball plan
    Every other part in this head had somewhere to go and the eyes did not: raked
    sockets, printed bezels, a clear bay behind them, and nothing at all to carry
    six servos. eye_plate is that something - a bulkhead at y 128..134, one
    millimetre behind the split, so it belongs to the cranium and goes in while
    that half is an open bowl. Measured, the interior there is 110-116 mm across
    against the ~100 the brief budgets, with 90 mm of depth behind. The eyeballs
    sit wholly in front of it; only the linkages reach through, which is what the
    two Ø30 bores are for. Held the tray_rail way, because that pattern is
    proven: run th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
2026-08-13 Withdraw the eye plate: the eyes and the ear hubs want the same space
    The bulkhead built an hour ago does not fit, and the reason is a finding
    about this head rather than a bug in the part. Each ear hub occupies
    x 29.5..65.5 over y 59..131 and z 163..246, on both sides. The eye line is
    z=209 and the mechanism needs ~100 mm across. Behind the y=135 split there is
    only 59 mm of clear width at that height, because everything outboard of
    |x|=29.5 is ear hub. No full-width bulkhead can exist there. The one built
    ran through both hubs, and its own side screws ran through them too - 79 of
    the right hub's vertices sat inside the z=188 hole.
    So it is withdrawn rather than patched, with the measureme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
    [head_mounts.py]
2026-08-13 Record what is open, including a hand edit the scripts cannot reproduce
    Four open items, written down because the session ends here and three of them
    are the kind that get silently lost.
    **The eye mechanism still has nowhere to bolt**, and the reason is now known
    rather than merely unaddressed: it wants the same space as the ear hubs. Each
    hub takes x 29.5..65.5 over y 59..131 and z 163..246, on both sides, so behind
    the y=135 split there is 59 mm of clear width at the eye line against the
    ~100 mm the mechanism needs. head_mounts.eye_plate is kept, uncalled, with the
    measurements and three ways forward on it.
    **A hand edit to HEAD_CRANIUM is not in the scripts and could not be
    recovered in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
2026-08-13 Put the ear hub arms where the skull has room, and stop rebuilds eating work
    Three things, and the first is the one that was visible on screen.
    **The ear hub's third arm was never a boss.** At 210 degrees the skull leaves
    2.59 mm between the hub's back plane and the wall, so the arm built as a
    0.07 mm disc with 72 of its vertices inside the shell and an M3 pilot drilled
    into nothing behind it. That lump, buried in the head on both ears, is what
    got reported. Measured at r=36 from the arm root, the whole lower-rear
    quadrant is dead - 190 to 260 degrees all come in under 6 mm - because the
    skull closes onto the hub there. No flat-ended boss seats on a wall that
    rakes 5.3 mm across its own foo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
2026-08-13 Refresh exports/ down to just the plate 3 parts, from the current geometry
    The old STLs predate the ear hub fix and the print-orientation fix, and the
    coupons were fit tests for hardware that has since been measured. Rather than
    leave nine files of unknown vintage next to eight good ones, exports/ now
    holds exactly the plate 3 set and nothing else.
    Each file is written in its print orientation and dropped so it sits on z=0,
    so importing one puts it on the bed the right way up. The _xN suffix is the
    quantity to set in the slicer, not the number of bodies in the file -
    cable_anchor_x4.stl is one anchor, as cable_anchor_x6.stl was.
    Checked by parsing the binaries rather than trusting the expo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
    [cable_anchor_x4.stl, cable_anchor_x6.stl, coupon_b0385_x1.stl, coupon_mg90s_x1.stl, coupon_neopixel12_x1.stl, coupon_pca9685_x1.stl, coupon_vl53l1x_x1.stl, eye_bezel_l_x1.stl]
2026-08-14 Print the ear hubs the other way up, on the posts instead of one arm tip
    Same swapped sign as the head halves, and it cost more here because the three
    arms are not the same length - each is measured to its own bit of skull.
    Ry +90 maps z = -x, which put the arms DOWN. The 50 degree arm stands 12.60 mm
    proud of the outer face against 1.59 and 2.32 for the other two, so the part
    balanced on that single arm tip: a 12.7 x 12.9 mm contact patch, the whole Ø65
    disc floating 11.6 mm in the air, and the visible face pointing at the plate
    where every support scar would land.
    Ry -90 rests it on the two speaker posts instead - 81.0 x 9.0 mm of stance,
    six times wider - puts the visible outer face up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
2026-08-14 Split the ear hub in two so both halves print flat, with nothing underneath
    The hub had features standing off BOTH faces - posts and spine reaching 10 mm
    behind the plug's back plane, arms reaching up to 12.6 mm past its front face -
    so no orientation put a flat surface on the bed. Arms down it balanced on the
    single longest arm tip, a 12.7 x 12.9 mm patch with the whole Ø65 disc floating
    11.6 mm in the air and the visible face pointing at the plate. Posts down it
    stood on two Ø9 circles with the disc 10 mm up. Rotating it was never going to
    fix that; the part was the wrong shape for one.
    Split on the plug's back plane at x=39.5 and both halves lie flat:
    ear_hub plug + arms, x 39.5.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
    [head_mounts.py]
2026-08-14 Record the shell repair: six holes cut, six plugged, and why neither is here
    Moving arm_a left the .blend holding a shell and a hub that were each
    internally correct and no longer agreed with each other. The shell carried six
    Ø3.4 holes on the old 90/210/330 circle and none on the new 50/170/290, so all
    six arms sat flush against solid wall with no way to reach them, and six open
    holes led to nothing. Comparing a part to its own copy on the plate reports
    everything fine - that check only ever asks whether a part matches itself.
    The file is repaired: six new holes cut, six old ones plugged with cylinders
    measured to each wall rather than assumed. Measured walls were 4.07, 5.34 and
    4.15 mm,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
    [head_mounts.py]
2026-08-14 Write down where this stopped, so tomorrow starts from facts not memory
    A long session that changed the ear hub, the shell it bolts to, and the plate
    layout, and ended with the one design question still open. All of it verified
    against the file rather than recalled, because the parts that bit hardest today
    were the ones everybody assumed they remembered.
    The entry worth reading first: the reason the eye plate was withdrawn is now
    STALE. Its docstring says there are 59 mm of clear width at the eye line
    because everything outboard of |x|=29.5 is ear hub. That was true of the
    one-piece hub. Splitting it leaves nothing in the ear assembly past y=127.5,
    and the zone now gives 120.4 mm at y=131 a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
2026-08-14 Export plate 4, and find out most of it was not watertight
    Plate 4 is the two ear hubs, the two spines and all five coupons. Exporting
    it meant looking at the files rather than trusting the export, and eight of
    the nine came out of Blender with holes in them.
    Two separate causes, neither a modelling mistake worth chasing back into the
    CAD, both now repaired on the throwaway export copy:
    Zero-area slits on four coupons and on ear_hub - a coplanar boolean seam
    leaving a T-junction, three short collinear edges tiling one long one with a
    zero-width face missing between them. coupon_mg90s had seven of them. They
    enclose no volume, so nothing would have printed differently, but every
    slicer stop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
    [cable_anchor_x4.stl, coupon_b0385_x1.stl, coupon_mg90s_x1.stl, coupon_neopixel12_x1.stl, coupon_pca9685_x1.stl, coupon_vl53l1x_x1.stl, ear_hub_l_x1.stl, ear_hub_r_x1.stl]
2026-08-15 Keep the sliced project files next to the STLs they came from
    Two Bambu Studio projects, tray_rail_r off plate 3 and ear_spine_r off
    plate 4. They carry the plate arrangement and the print settings that
    produced a part that actually came out, which is the half of "how was this
    printed" that an STL does not record.
    Same folder-per-plate rule as the STLs. Plates 1 and 2 stay out of git
    regardless of format - they are HEAD_CRANIUM and HEAD_FACE.
    Claude-Session: https://claude.ai/code/session_017AS9E3tzFN5ESc6osTJb4Q
    [ear_spine_r_x1.3mf, tray_rail_r_x1.3mf]
2026-08-15 Do not "repair" a part that is already a closed solid
    print_clean() ran unconditionally, and on the two head halves that was
    destructive: HEAD_CRANIUM went in at 0 open / 0 non-manifold and came out at
    212 / 12434, HEAD_FACE at 362 / 8340. Both were perfectly closed solids
    before it touched them.
    The culprit is dissolve_degenerate, not the weld, which is worth writing
    down because the weld is the one that looks dangerous. Tested at 0, 1e-6,
    1e-5 and 1e-4 on both halves: remove_doubles alone merges at most 27
    vertices and 2 faces and leaves the volume identical to three decimals.
    dissolve_degenerate is what tears a 99k-vertex sculpt apart - it collapses
    edges that are legitimately that short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
2026-08-15 Write down the assembly order, and what will stop it
    All four plates are exported now. Plates 1 and 2 will not share a plate -
    134 and 122 mm side by side is exactly 256 with no clearance - and at 425 g
    of PLA between them they are a day each, not a day for both.
    The assembly order matters more than it looks: every coupon gets offered up
    to its real board before anything is bolted to anything. Three parts already
    printed on plate 3 rest on numbers only a coupon can confirm, and
    coupon_mg90s is the valuable one - servo_tab_pitch = 28.0 is listing-grade
    and is not dimensioned in any drawing anywhere.
    Also recorded because it is the most likely thing to stop an assembly day
    dead: fasteners ar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
2026-08-15 Weld the ear hub bosses on, because they were never attached
    The three bosses on each ear hub printed as loose pegs. They were not
    weakly joined - the hub exported as five separate solids, the bosses
    standing 0.461 mm clear of the plug's rim.
    The arms were clipped with INTERSECT against MOUNT_ZONE, and the zone has
    the Ø66 ear port subtracted out of it. An arm is Ø13 on a r=36 circle, so
    it spans r 29.5..42.5 and its only overlap with the Ø65 plug is a lens at
    r 29.5..32.5 - entirely inside r=33, entirely inside the port cutter. The
    clip deleted exactly the material that welded each boss on. The comment
    said the arms sat "well outside the Ø66 bore": true of the axis, false of
    the body.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
    [ear_hub_l_x1.stl, ear_hub_r_x1.stl]
2026-08-15 Put the hand-edited casing where the exporter can see it, and open plate 5
    forehead_casing's hand edit - an enlarged S4B-ZR camera cable exit, 592 mm3
    of material and the engraved B0385 lettering with it - was on
    PR_forehead_casing, the plate copy. export_plate() reads the source. A
    re-export would have quietly printed the 13 Aug part again, and the
    assembly's FIT_forehead_casing was showing that same stale geometry.
    Which copy held the edit was settled rather than assumed, because guessing
    wrong destroys it: the source matched exports/plate3/forehead_casing_x1.stl
    exactly, 4760 triangles and 17910.5 mm3, so it had not been touched since
    13 Aug, and all ten other plate-3 copies agreed with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
    [forehead_casing_x1.stl]
2026-08-15 Record that the MG90S servos fit the coupon
    servo_tab_pitch = 28.0 was listing-grade and carried every servo pocket in
    the eye mechanism. Tested against real hardware on 15 Aug: it fits.
    Claude-Session: https://claude.ai/code/session_01WAR5ZFPvcZ19z5o7zmmCVa
2026-08-15 Relieve the camera pocket corners, so a square B0385 actually seats
    The pocket is rounded to corner_r + board_clear = 2.5 mm, because Arducam's
    dimension drawing gives the board a 2.0 mm corner radius. The board in hand
    has square corners. Measured in the mesh: the pocket reaches a diagonal
    18.77 mm from centre and a 38 mm square board's corner is at 19.00, so it
    stood 0.23 mm proud at all four corners and would not seat. Two screws went
    in and the third and fourth did not.
    Ø3 reliefs at the four corners rather than corner_r = 0. Setting the radius
    to zero asserts the drawing is wrong in one specific way and leaves a sharp
    internal corner that a 0.4 mm nozzle cannot cut, which puts the fit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
    [forehead_casing_x1.3mf, forehead_casing_x1.stl]
2026-08-15 Thin the PCA9685 standoffs off the pin tails, and print one eye plate not two
    The mount's holes were confirmed good against the real board; only the
    standoffs were wrong. At Ø7 each reached 3.5 mm inboard of a hole that sits
    3.175 mm from the board edge, so it ran in under the servo header field and
    the pin tails fouled its inner edge. Ø5 buys a millimetre all round and still
    leaves 1.4 mm of wall around the M2 clearance - 0.9 mm at the slot ends,
    which is two perimeters and carries no load, because the screw clamps the
    board down onto the boss rather than hanging off it.
    pca9685_mount joins plate 5, so all four reprints come off in one run:
    both ear hubs, the relieved casing and the thin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
    [pca9685_mount_x1.stl]
2026-08-15 Open the PCA9685 plate out under the board
    The standoffs already held the board 3.5 mm clear, which is enough for pin
    tails and solder blobs right up until someone solders a header slightly
    proud or leaves a tail long. A window under the whole board footprint means
    there is nothing to hit at all, and that is worth more than 3.5 mm of
    measured margin. Soldering on this board is on the BOTTOM face - headers sit
    on top, pins pass through, joints underneath - so the bottom is exactly
    where the clearance has to be.
    The window swallows all four mounting holes, so each boss now rides on a pad
    bridging out to the surviving frame. The pad hugs the boss: inboard it
    reaches |x| 25.0 against the boss's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
    [pca9685_mount_x1.stl]
2026-08-15 Ear hubs to a plate of their own; plate 5 is now just the two reprints
    The hubs are printed off the earlier plate 5 and do not need running again,
    so they move to plate 6 rather than being deleted or crammed back onto
    plate 4. One part still lives on one plate, verify() keeps checking them,
    and the corrected STLs stay somewhere obvious if a hub is ever needed again.
    Plate 5 is forehead_casing and pca9685_mount, 14.3 mm apart. Plate 6 is the
    two hubs, 7.6 mm apart. Both verified from the files: one shell each, every
    edge shared twice, zero degenerate triangles.
    forehead_casing_x1.3mf was sliced at 10:53 from the casing as it was BEFORE
    the corner relief, so reopening it would quietly print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
    [ear_hub_l_x1.stl, ear_hub_r_x1.stl, forehead_casing_x1.3mf]
2026-08-15 Delete the superseded/ folders - git already keeps that record
    They were added this morning to preserve what had actually come off the bed
    while getting known-bad files out of the folder you drag into a slicer. The
    second half of that was worth doing; the first half was not, because git
    history already holds every one of those files and can hand them back with
    `git show`. All they did in the working tree was make it ambiguous which STL
    is the one to print.
    exports/ is now one folder per plate, current geometry only, nothing else.
    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
    [ear_hub_l_x1.stl, ear_hub_r_x1.stl, forehead_casing_x1.3mf, forehead_casing_x1.stl, pca9685_mount_x1.stl]
2026-08-15 Retire the ear spine: the speakers are glued on
    The speaker is a Waveshare 8 ohm 5 W, 100 x 45 x 21 mm - the one bundled
    with the WM8960 Audio HAT. BOARDS["speaker"] said 70 x 30 x 16 and was
    marked UNMEASURED with "nothing is built to them yet", except two things
    were: ear_spine's 80 mm height and its 72 mm post pitch. The real part is
    100 mm long, so it could never have bolted to those posts, and its mounting
    holes are too small to take a screw.
    So it gets glued to the back face of the hub, which the root flares happen
    to have improved - flush at x=39.5 and lobed rather than a plain disc, about
    95 mm across. The spine has no job left. Both are already printed, so nothing
    was wasted, and t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
2026-08-15 Settle eye_pitch at 62, and unblock the head halves
    It was never an open decision, only an unrecorded fact. head_style.S["eye"]
    has carried pitch=62.0 with rake_out=25 and rake_down=10 all along, and the
    sockets were cut on it. The "sculpted sockets at 56" note was stale.
    Confirmed against the geometry rather than taken from the constant: sweeping
    -y rays across HEAD_FACE and comparing each hit against HEAD_SOLID clusters
    into four openings - the eye sockets at x = +/-34.0, 36 wide by 40 tall,
    centred z = 205.6, and the ear ports at +/-67. Those numbers are pitch 62 seen
    through the rake. The apertures sit at +/-34 rather than +/-31 because 25
    degrees of outward rake carries them outboard o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
    [forehead_casing_x1.3mf]
2026-08-15 Start the bespoke eye mechanism: domes, gimbal and frame
    Cogley's e3.2 is reference only from here. The licence is the reason that
    actually matters - CC BY-NC-SA, so none of his geometry could ever ship in
    this repo - and every one of his plates needs support material, which nothing
    else in this project does.
    Four servos against his six: pan and tilt both linked across the eyes, plus
    one lid each so they can wink independently. What that gives up is per-eye
    pan, which buys convergence; subtle, and it doubles the linkage count.
    Three decisions shape the rest:
    A gimbal, not a ball in a socket. Two pushrods pulling on one free body fight
    each other and every bit of slop in one shows up in th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
2026-08-15 Model the servos and test for collisions - both change the design
    Two gaps, both found by looking at the screen rather than by any test, which
    is the point: check() proved every part sat inside the head and never once
    asked whether the parts pass through each other. Containment and collision
    are different questions and it only asked the first.
    With the collision test in, the mechanism fouls the forehead casing, both eye
    bezels, the face half's socket wall, and - worst - the temple pads it is
    supposed to bolt to. The pad is not a free-standing boss; it is a lump merged
    into the 4 mm wall, so the only feature that can actually be used is the
    Ø5.2 bore, and a mounting disc placed over it is s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
2026-08-15 Place the four servos where they can actually drive something
    Not just where they fit. A servo's shaft has to be parallel to the axis it
    drives or the linkage stops being planar, so pan gets a vertical shaft - it
    moves a bar along X - and tilt and both lids get shafts along X, because they
    drive levers pivoting about X. The first hand-placed layout had tilt vertical,
    which would have driven nothing.
    Found by search, not by eye. Every candidate was tested four ways: inside
    MOUNT_ZONE, against the other three servos, against the mechanism, and
    against every part already in the head. The hand-placed version failed on
    three of those - pan and tilt overlapped, and the right lid servo went
    straig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
2026-08-15 Clear every clash in the eye mechanism, and retire the eye bezels
    From eleven collisions to none. Most were not close calls, and the useful
    output is the wall map: the face half's inner surface was traced ray by ray
    and it closes in hard going forward - x 53.7 at y=147, 52.7 at 150, 51.5 at
    153, 50.5 at 156, and 49.0 by y=162. Nearly every part was sized against a
    guess at that number. Now they are sized against the number.
    The genuine design error was the pan lever pointing sideways. Linked pan
    needs both levers offset the same way, so one of them always ends up
    outboard - x=42 for the right eye - and there is skull there from x=44.5 at
    y=144. Pointing them BACKWARD is symmetric, keeps eve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
2026-08-15 Check the eye parts against each other, and find the bearing is in the wrong place
    check() compared every part to the head and never to the part next to it.
    Containment, collision-with-the-head and collision-with-each-other are three
    questions and it was answering two - which is the same gap it had before,
    one level in. Pat spotted it on screen again: hide the gimbal and it is
    inside both frames.
    With the third test in, four parts interpenetrate, and one is fatal:
    eye_frame_R INTO eye_lid_R
    The eyelid is a shell OVER the ball, outer Ø35.6, so it reaches x=48.8 -
    further out than the eyeball's 47 and straight through the tilt bearing at
    48.5. The three-millimetre window that justified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
2026-08-15 Give the eyes lids, and make the mechanism survive being moved
    check() only ever tested the mechanism standing still, and that hid two
    faults that matter more than the one it did find. Posed through its range,
    a yoke arm over the top of the eye swings six millimetres into the forehead
    casing, and the pan bar's ends translate straight through both eyelid
    pushrods at full pan.
    So the eye hangs on one journal underneath now, the top of the ball is left
    empty, and the tilt bearings moved off the outboard slot - which was never
    3 mm wide once an eyelid was in it - into the corridor between the eyes.
    Frame, gimbal and lid all turn on one shaft there, nested, which is what
    being concentric with th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
2026-08-15 Cut the casing for the lids, and find the pan rod rubbing its own bar
    The eyelid needed 2 mm out of the forehead casing and there was never a way
    round it, so it is cut. Both copies: the cutter is built in world space and
    the source part is parked out on the print bed at x=520, so a box at x=+-31
    missed it entirely and reported no error - it "cut" 1567 vertices into 1567.
    The copy in the head is cut now and the source is handed that mesh. Plate 5
    has to be re-exported.
    check() passes at all twenty-nine poses.
    clearances() is new, and it found something the overlap test could not:
    pushrods live in ALLOWED, because a rod in its own pin hole is a joint, so
    nothing was ever measuring them. The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
2026-08-15 Put back the note that the eyeball domes do not print as claimed
    Lost in the rewrite two commits ago, which is exactly the kind of quiet
    regression these notes exist to stop. Nothing about it has been fixed.
    Claude-Session: https://claude.ai/code/session_0112N6XwBvYp4LGMmfv3HbuX
2026-08-15 Put the pushrods in the plane their own hinges turn in
    Pat spotted this on screen before any test did: the eyelid rod appeared to
    stab through the crank rather than sit in its pin. It was doing exactly that.
    Every joint in the linkage is a hinge, not a ball - the lid turns about the
    tilt axis, the horn about its own shaft, both along X - so a straight rigid
    rod can only join them if it lies in a plane perpendicular to X. The crank
    pin had been dog-legged out to x=16.3 to dodge the tilt tube while its servo
    stayed at 12.8, and two parallel hinges offset along their shared axis cannot
    take a straight rod at all.
    skew() is the check that was missing. It reports the tilt rod was 4 mm out
    and th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
2026-08-15 Draw the servo horns, because every picture so far was missing a link
    The horn is the white arm that comes in the bag with the servo and clips to
    its output shaft, and it is what turns shaft rotation into a push on the
    wire. It was never modelled, so every render showed a pushrod running to a
    bare servo body with nothing joining the two - which is not a small omission
    when the person reading the picture has not used a servo before.
    Not a printed part, and not optional. Drawn as PROXY_horn_*, redrawn with
    the rods on every pose, so it is always at the angle the linkage actually
    solves to.
    check() still passes.
    Claude-Sessio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
2026-08-15 Size the link holes for 2 mm rod
    Pat's call. O2.30 against a 2 mm bicycle spoke - +0.3 for a joint that has to
    pivot, where this project uses +0.2 for an M2 free hole and +0.4 for an M3.
    The rods are drawn at their real 2.0 now too, so clearance() is measuring the
    wire rather than a placeholder; everything got 0.25 mm roomier as a result.
    Only three of these holes take wire. The eyeball-to-bar joints are printed
    pins on the domes, and those follow the hole at -0.15 for a running fit.
    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
2026-08-15 Give the eyes an iris and a pupil, and the pixels a pad to sit on
    The pupil is the shell thinned from the inside to 0.9 mm over a O6.5 circle,
    so the 5050 lights it and the rest of the ball stays opaque; the iris is a
    O15 disc recessed 0.4 into the front so the eye reads as an eye unlit. Both
    are a sphere clipped by a cylinder, because a flat-ended cutter cannot put a
    controlled step into a ball - sunk deep enough for 0.5 mm of step it only
    reaches r=3.97, and a "O15 iris" came out O7.9.
    The pixels glue to the rib across the back of each dome, which is 10 mm tall
    now so it can be their pad. They had been sitting 66 faces inside it for as
    long as both existed, unreported, because check() ski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
2026-08-15 Split the eyeball into three, and measure printability instead of arguing it
    The dome could never have printed as one piece: the pan lever reaches 4 mm
    behind the only face it can sit on, the bearing boss hangs 16 mm below the
    ball, and those two point at right angles. The docstring had claimed flat-
    back-down since the file was written.
    printability() is the tool that settles this class of question - downward
    area past 45 degrees, and crucially how far above the bed it starts, since a
    face that overhangs on the first layer is a chamfer and the same face 10 mm
    up is a support.
    So: dome (shell, iris, pupil, and a bore up its bottom pole), stem (spigot
    into the back opening, carrying the lev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
2026-08-15 Teardrop the bearing bores, and lay the eye mechanism out on its own plate
    Every bore in the gimbal and the frame runs horizontal in the orientation
    the rest of the part wants, so each gets a roof: the round profile is
    untouched and the material above it self-supports. Each roof needed its own
    boolean - merged into the bore's own cutter they are two overlapping solids
    in one mesh, which broke three parts before it was spotted.
    Then the plate. 11 files, 14 pieces, 172 x 152 mm of a 256 bed, in its own
    collection so export_plate's census cannot see it, and its own exports/eye
    folder.
    chirality() is the new check and it earns its place immediately: volume,
    bounding box and the vertex fingerpr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
2026-08-15 Commit the eye plate STLs that cad/eye_plate.py just wrote
    The 11 files eye_plate.export() produced, matching the census in 195eca1:
    14 pieces across 172 x 152 mm. exports/ is tracked on purpose - this is
    our own geometry, and keeping the exact file that went to the slicer is
    the point. Plates 1 and 2 stay ignored for the licence reason.
    Claude-Session: https://claude.ai/code/session_01QS6MXpndosuq9Beoeq9Mqv
    [eye_axle_r_x2.stl, eye_dome_l_x1.stl, eye_dome_r_x1.stl, eye_frame_x1.stl, eye_gimbal_x1.stl, eye_lid_l_x1.stl, eye_lid_r_x1.stl, eye_pan_bar_x1.stl]
2026-08-16 Measure what the eye plate stands on, and find the frame standing on nothing
    printability() answers how much of a part overhangs. It cannot answer whether
    the part is sitting on anything, and those turned out to be different
    questions: eye_frame laid "flat on its arch" touched the bed with 0.0 mm2 of
    a 557 mm2 shadow. The mast tip stands 2.5 mm proud of the arch, so 104 mm of
    part balanced on a single 4.8 mm edge with its whole underside in the air.
    It exported that way and nothing in the file could see it.
    printcheck() is the gate. It judges a first layer against the part's OWN
    shadow rather than a flat mm2 limit - a O5 peg on its end contacts 19.5 mm2
    and that is 100% of it, while the fra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
    [eye_frame_x1.stl, eye_lid_l_x1.stl, eye_lid_r_x1.stl, forehead_casing_x1.stl]
2026-08-16 Drop the gimbal's floor a millimetre instead of cutting its bearings back
    printcheck() returns True. The eye plate is cleared to print: 11 files, 14
    pieces, and the only slicer setting it needs is a brim on the two eyelids.
    eye_gimbal was the last part failing, sitting on 100 mm2 of a 1532 mm2
    shadow. The cradle floor was at y=154.0 while the tilt lever hung to 153.0
    and both O13 journal housings bulged to 153.5, so 620 mm2 of the face that
    carries both pan bearings was a millimetre in the air on a 10 mm lug.
    Trimming those three flush was the plan and the measurement killed it: it
    takes the wall under both pan bores from 1.35 to 0.85 mm and under the tilt
    link pin from 1.85 to 0.85 - thre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
    [eye_bezel_l_x1.stl, eye_bezel_r_x1.stl, eye_dome_l_x1.stl, eye_dome_r_x1.stl, eye_gimbal_x1.stl, eye_lid_l_x1.stl, eye_lid_r_x1.stl]
2026-08-16 Write down what to buy, and find the wire is a craft-store part
    docs/shopping-list.md. Counts read out of the CAD rather than remembered:
    ~12 x M3, 4 x M2.5, ~16 x M2 plus nuts, and 2 mm music wire for the four
    pushrods.
    The useful find for tomorrow's Michaels run is that the pushrod stock is
    there: K&S music wire .078 x 36in, and .078 is 1.98 mm against the 2.30 mm
    link_d that was cut for 2 mm rod plus clearance. One 36in length is three
    times what the mechanism needs - the four rods measure 49.6, 44.9, 44.9 and
    34.2 mm, 174 mm in total - so the 3-pack is nine attempts at bending four
    rods. Michaels will NOT have the screws; it is a craft store and big-box
    metric drawers mostly start at M3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
2026-08-16 Print the eye mechanism, break three parts, and find one fault behind all of them
    The mount snapped at the left temple and at the shaft; both eyelid cranks
    came off the bed as fringe. None of it was a load that came out wrong. Every
    one of them was a slender member printed as an unsupported cantilever:
    the peg retained by two printed lips 0.5 mm thick - one nozzle width
    the mast 80.7 mm2 of 23-degree slab over open air, 17.3 mm up
    the crank 24.6 mm2 of flat slab over open air, 3.9 mm up
    printcheck() returned READY for all three, and that is the finding. It
    measured how a part SITS - bed contact against its own shadow, flat ceilings
    within 20 degrees of down - and nothing mea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
    [eye_axle_r_x2.3mf, eye_dome_l_x1.stl, eye_dome_r_x1.stl, eye_frame_x1.stl, eye_gimbal_x1.stl, eye_lid_l_x1.stl, eye_lid_r_x1.stl, eye_peg_r_x2.stl]
2026-08-16 Stand pillars under the casing bosses the face half printed into thin air
    The face came off the plate with all three forehead-casing bosses snapped
    off and dragged around as loose rings. The mesh was never at fault -
    PR_HEAD_FACE is one connected shell and the bosses are welded to it. Laid
    rim-down, model +Y becomes print +Z, so the bosses' free ends are the LOW
    ends: they land at print z=32 with the shell they hang from 16-28 mm above.
    A ring of plastic with no layer beneath it and nothing at its own height to
    anchor either end - not something slicer bridging can save, because a bridge
    needs two anchored ends and this has none.
    It cannot be fixed in CAD either: the volume under those bosse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
    [print_supports.py]
2026-08-16 Add Pi servo dependencies
2026-08-17 Clear the decks: keep the gates, drop the v1 geometry, restart on the eyes
    v1 was assembled far enough to fail honestly, and every failure it produced was
    about BUILDING - printing it, wiring it, servicing it - rather than about shape.
    The shapes go. The tests they were paid for stay.
    WHAT SURVIVES, AND IT IS NOT THE GEOMETRY
    cad/checks.py is new: printcheck, aircheck, print_clean, weld_debt,
    loose_parts, chirality and _inside_test, lifted out of eye_plate.py,
    export_plate.py and ear_hub_repair.py before those were retired. Moved BY
    SCRIPT rather than by hand - retyped code is code with new bugs in it - and
    the header records what each one cost. _print_stats and _air_stats were
    already pla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
    [cable_anchor_x4.stl, coupon_b0385_x1.stl, coupon_mg90s_x1.stl, coupon_neopixel12_x1.stl, coupon_pca9685_x1.stl, coupon_vl53l1x_x1.stl, ear_hub_l_x1.stl, ear_hub_r_x1.stl]
2026-08-17 Rebuild the eye on three servos that can drive, and catch the pan four-bar two degrees from lock
    The v2 eye, first commit: tilt direct-driven from inside the right base
    upright (the shaft IS the right pivot, horn in a pocket in the gimbal's
    boss), pan and blink riding ON the gimbal so tilt cannot drag their
    linkages, six pin joints against v1's twelve and no wire anywhere.
    The pan drive earned its own lesson. Placed straight behind the tab it
    solved to 6.6:1 near look-right 20 degrees - two degrees short of locking
    over-centre - found only by solving the four-bar across the whole travel
    instead of admiring it at neutral. Now it is a parallelogram: horn arm
    parallel to the eye levers, equal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
    [checks.py, eye.py]
2026-08-17 Put the whole robot on a bench slab, and let the head be designed around what works
    Pat's call: assemble and wire the hardware on an open-faced chassis with
    room to work, then rework the head mesh to house what actually exists -
    eye.py's chassis-first law applied one level up. cad/bench.py draws the
    deck IN the eye mechanism's world frame (deck top = z -64 = the floor
    bottom), so every placement decided at the bench is already a coordinate
    the head rework can read.
    One printed part. The eye base drops into a raised-rim bay and four edge
    tabs screw into its floor edges - no holes needed in the part that is on
    the printer right now. PCA9685 and Pi 5 sit on bosses using the hole
    patterns rack.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
    [bench.py]
2026-08-17 Record every bench placement as numbers, and give the SHT41 a home behind the PCA
    STATIONS is the deal memo: forehead casing (nudged up 9.9 by hand for
    breathing room), camera and ToF axes on its one row, the Waveshare
    speakers high on the skull sides where the dome is empty above the cage -
    x +-63..84, inside the +-86 eye-band envelope, firing outward - and the
    SHT41 on the deck floor behind the PCA, on the far side from the Pi's
    heat plume. The speaker flange pattern is 92 x 36 MEASURED from the
    listing drawing; v1 carried 72 as an unmeasured guess and said so.
    The deck grows four bossed M2.5 pilots on the Adafruit 20.32 x 12.7
    pattern. Gate READY, STL re-exported. The head file reads STA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
2026-08-17 Take the SHT41 holes back out - the board on hand is not the one the guess fit
    Pat looked at the real board and it is not the Adafruit breakout, so the
    20.32 x 12.7 pattern would have been four confident little lies in the
    deck. Mounting is deferred, the reasoning stays in STATIONS: behind the
    PCA and away from the Pi's heat is still the right neighbourhood, and it
    ties down in the cable channel until its holes are measured, not guessed.
    STL re-exported without them.
    Claude-Session: https://claude.ai/code/session_01AcsEg6jmdLvbeKmjtTDFRx
2026-08-17 Raise a brow gantry so the camera gets geometric truth before the head exists
    Two legs in the x 47..55 lane - the one corridor the swept mechanism
    never enters - up from deck feet to arms that cross over the parked lids
    and hold a cradle at STATIONS["casing"]. The cradle grips the casing's
    outline instead of its holes, because the holes belong to the camera:
    shelf under, rails behind on the margins no board reaches, stops beside,
    two screwed keeper clips on top. The casing drops in and lifts out
    undrilled. Cable ways for both leads; the ToF notch is open-front with a
    1.8 web because cutting it through severed the rail and orphaned the
    whole bottom-left of the frame, which health() caught as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
2026-08-17 Write the bench tool before the mechanism exists, because assembly needs it first
    The assembly sheet's step 6 is "centre the servo electrically, THEN press
    the horn on" - so the software is a prerequisite of assembly, not a
    follow-up. eyes_bench.py owns the PCA9685: channels 0/1/2, limits in EYE
    degrees straight from the CAD's verified sweeps (the drives are all 1:1
    by design, so there is no ratio table to get wrong), direction and
    neutral discovered at the bench with `invert` and `trim`, every move
    slewed at 30 deg/s, and everything limp on start, exit, and Ctrl+C. A
    full-speed step into a fresh printed linkage is how v1 broke parts.
    Compiles clean; runs on the Pi where the hardware is.
    C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
    [eyes_bench.py]
2026-08-17 Throw scripted clay at the cube-with-eyes fear, and watch it lose
    A metaball massing study around the committed envelope: +-90 exterior at
    the eye band (measured after the field maths spoke, then scaled once -
    stated width beats wished-for width), sockets cut to Ø36 for the real
    Ø32 eyes, landmarks where faces keep them. First draft was eleven
    separate eggs because metaball fields only fuse where they overlap;
    second draft wore the face skin BEHIND the eyeballs; the glabella
    element exists because without it the blink hardware showed through the
    middle of the face.
    What it settles: a skull 20 percent wider than human, with brow, orbits,
    cheeks and chin in the right places, reads as a chun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
2026-08-17 Void the tilt clamp screw - Pat went looking for a hole that was never there
    The horn pocket's access bore dead-ends inside the lid hinge stub, so
    the centre screw could never be driven. Measured the real meshes: 1.0 mm
    of gimbal float between the uprights vs a 2.1 mm horn slot - the joint
    is captive by geometry and never needed the screw. Sheet and comments
    now say so; the printed part is already correct as-is.
    Claude-Session: https://claude.ai/code/session_0189xvgZkZcjEp6enYtEQud2
    [eye.py]
2026-08-17 Cut the tilt horn pocket where the horn actually is - Pat tried the old one and it does not go
    The v2 pocket sat at x 61.4..63.5, but a horn pressed fully home on the
    mounted servo has its plate out at ~65: the spline bottoms in the hub
    1.5 mm before the arm can even touch the boss face. Pat asked about this
    joint several times and I explained the intent instead of checking reach.
    v2.1: boss extended to x 67.0, slot 3.6 mm deep and 6.2 wide, hub/spline
    recess to 61.5 - the horn self-locates anywhere in a 3 mm window. The
    centre-screw access bore is deleted (it dead-ended inside the lid hinge
    stub). HEALTH PASS, gate READY, zero exact-boolean clash vs servo and
    base across tilt +-16. Only ey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
2026-08-17 Draw the third horn - the invisible coupling was the one that kept shipping broken
    [eye.py]
2026-08-17 Give the gimbal STL four plain support blocks - the little cubes Pat asked for
    Two blocks under the floating pan shelf and wing, one on each arm top
    reaching up under the O5 hinge stub, every face 0.2 clear of the part.
    Baked into eye_gimbal_x1.stl as extra shells; sheet says supports OFF
    for that part. Exact-boolean vs the part: 0.000.
    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
2026-08-17 Move two zip stations off the gantry foot pilots they were eating
    The O4 zip holes at x +-48 sat 3.0-3.2 mm from the O2.2 foot pilots at
    +-51 - radii sum 3.1 - so in the printed deck each pilot fused with its
    zip hole into a keyhole slot and the foot screws had nothing to bite.
    Pat found it at assembly and is working around it on the printed deck
    (drive the screw against the slot's outboard wall). Future decks: those
    stations now live at +-42, 5.9 mm of real wall from the pilots and 3 mm
    clear of the foot itself. Gate READY, exports refreshed.
    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
2026-08-17 Scrap the brow gantry - the casing mounts to the head, Pat's call
    The two 8 mm legs flexed under the camera+ToF weight, their deck pilots
    died fused to zip holes, and the forehead casing was always headed for
    the head anyway. The bench did its job: the casing is proven and its
    placement numbers live on in STATIONS for the head file to read. Gantry
    functions, PLATE rows, deck foot pilots, and stale STLs removed; the
    casing and sensor proxies stay in the scene as the head's spec. A USB
    webcam covers vision work until the head exists.
    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
    [bench.py]
2026-08-17 Make the eye assemblable where Pat's hands actually are
    Three finds from the bench, one commit:
    - Blink servo could never be installed: the closed window only admits
    the body by an x-slide from inboard, and the shelf slab owns that
    corridor. The window is now a slot open to the plate's front edge -
    the servo drops in from -y at its final position, verified clash-free
    along the whole path. Pat hand-cuts the printed gimbal to match.
    - Sideways O1.7 tab pilots (tilt in the base, blink in the gimbal)
    skinned over in the print - now O1.9 and through the wall.
    - The deck's tab screws bite eye_base's bare floor edge; "no holes in
    eye_base needed" cost Pat a tapper skating on PLA. Four O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
2026-08-18 Bolt the eyeball to the horn - the printed key was never driving it
    Three eye mechanisms have been printed and bench-tested and the eyes never
    moved. The servos always did. The reason is one joint: in cad/eye.py the pan
    torque reaches the ball through a 1.0 mm printed key flat, in a bore cut
    0.40 mm oversize, at a 3 mm radius, in PLA. Everything upstream can turn
    exactly as commanded and the ball still sits there, and once that flat's
    corners round over it is a plain pin in a plain hole.
    So: nothing printed transmits torque through a fit. The ball is bolted to an
    OEM servo horn - moulded to the spline, clamped by the bag's centre screw,
    tied to the ball by two self-tappers through its own a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
2026-08-18 Give eye_direct a numbered export - the print order is the instruction
    The coupon settles HORN['hole_r'] and the balls' seat depth is derived from
    it, so printing a ball before the coupon risks two scrap balls. Numbering
    the files 1..4 puts that in the folder rather than in a doc nobody opens at
    the printer. Servos and horns are never exported - they come out of a bag.
    Claude-Session: https://claude.ai/code/session_01CRYrQ6NsVU1L7kaX8XVkWq
2026-08-19 Retire cad, docs and exports to research archive 01
    Every head shell this project has ever drawn is cut from a sculpt under a
    No AI licence: fine in a private build, never redistributable. The goal is
    now a robot head engineers can buy, so that geometry can never ship - and
    patching around it would only mean discovering the block after the design
    work was done.
    So the rework starts from an empty root. cad/, docs/ and exports/ move
    whole into `research archive 01/` as git renames, history intact. What is
    in there is reference to mine, not a codebase to extend: measurements,
    servo specs, and the failure gates in checks.py are fair to carry forward.
    Shapes are not.
    Nothing in .gitignore neede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
    [bench.py, checks.py, eye.py, eye_direct.py, head_mounts.py, head_ref.py, head_split.py, head_style.py]
2026-08-19 Two human eyeballs, from five numbers and an arc
    First original geometry of the rework. Nothing here is traced, imported or
    derived from the No-AI sculpt, which is the whole point: it has to be
    shippable in a product.
    Adult eyeballs vary by about 1 mm across the population - less than the
    tolerance on a 0.4 mm nozzle - so sclera radius, corneal radius, limbus
    diameter, anterior chamber depth and IPD are constants, not styling. What
    they are NOT is independent: the corneal sphere's centre is solved so that a
    7.8 mm arc passes through the limbus ring on an 11.6 mm ball. Change the
    limbus and the cornea re-solves itself, apex and all. The check that they
    agree is the axial length that falls ou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
2026-08-19 Eyelids on one axle, and a checker that stopped lying
    Both eye centres lie on one line, so the left and right lids of a rank share
    a hinge rather than having two. Each rank is one bail on a fixed axle, welded
    to its two shells. The servo cannot sit on that line - two MG90S pointing
    opposite ways need 54 mm of a 39 mm corridor - so a parallelogram absorbs the
    offset: 8 mm crank, 8 mm tab, conrod equal to the offset. 1:1, no dead point,
    no slot. Lid-to-ball holds flat at 2.100 / 0.500 mm through the whole blink,
    against -3.056 mm for a bail welded straight to the spline.
    The axle is carried from behind. Every sector around it is swept by something
    except theta 0, and the tabs that pass throug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
    [Robot_Design2.blend]
2026-08-19 Drop eyeball.py; the balls live in the blend now
    It built eye_L and eye_R - original geometry, five numbers and an arc, and the
    first clean-sheet part after the No-AI sculpt was retired. The two spheres it
    made are still in the scene and the scene is now tracked, so nothing is lost.
    What is lost is that they were REPRODUCIBLE. eye_lids.py does not build them,
    it looks them up by name, so the eyeballs now exist only as binary. Every
    clearance the lid rig is checked against - the flat 2.100 / 0.500 mm, the
    boolean test for anything buried in the ball - is measured against geometry
    that no longer has a source file.
    Claude-Sess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
2026-08-19 Retire mockups to research archive 01, and fix the paths that pointed at it
    cad/ and docs/ went in d6fa8af; mockups/ and the old exports/ follow. The
    exports move matters more than the tidiness: exports/eye/eye_lid_l_x1.stl and
    eye_lid_r_x1.stl were dated 17 Aug and cut from cad/eye_v2.py, the design
    before the one-axle rework. They were the most eyelid-looking files in the
    folder and they were wrong. That is the exact failure this file's own comment
    records from v1 - two parts printed after being superseded - and the fix is
    the same one: get them out of the way of the current set.
    exports/eye_lids/ now holds eight STLs cut from Robot_Design2.blend, which is
    the first time anything has been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
    [eye_lids.py]
2026-08-19 Cut the conrod bores, and probe every hole with the pin that goes in it
    The conrod's eyes were tubes and its 5.0 wide bar ran pin centre to pin
    centre, so the union swallowed both 3.4 bores and left two D-shaped half
    holes - open away from the bar, solid where it came in. Manifold, one
    piece, no clash, right size outside, and no pin fits. Two rods reached the
    printer that way. Everywhere else in the file the plate that meets a bore
    starts outside it (the tab at r=3.2 on a 2.2 bore, the crossbar webs at
    2.3); the conrod is the one place that could not, because centre to centre
    is what makes the parallelogram exact. So the eyes are solid discs now and
    the bores are CUT, after the union.
    check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
    [Robot_Design2.blend]
2026-08-20 Drive the eyes, mount the servos, and stop the checker lying
    Printed pushrods and horns, so the rig needs no music wire and no ball
    links. Rods are flat bars with snap-on eyes, mouths opposed; horn bores
    run under the spline so the teeth cut their own.
    Real servo cradles. The pan case was passing straight through its shelf,
    hidden behind a whitelist entry that said "bolted to it". It now drops
    into a slot open at the back, ears on rails, two M2 pilots; the tilt
    servo slides in from the side onto two posts.
    The eye is its own part again. No arm over the top of the ball, so the
    whole top is free for lids, and it drops onto a cross-tipped pole that
    takes torque on four flanks instead of creep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
2026-08-20 Back up the blend: eye rig with drive linkage, servo mounts, cut eyes
    Working copy from C:\H\Robot_Design2.blend.
    Scene state: eye rig built and passing, parenting cleared for
    inspection so look() will not drive the pose until build() runs again.
    Eyes carry their cut geometry (socket, seating flat, pupil dish); the
    plain spheres are kept as the eye_L_uncut / eye_R_uncut meshes.
    Claude-Session: https://claude.ai/code/session_01KVzSGLgEkckj4Ms1i1uGUX
    [Robot_Design2.blend]
2026-08-20 Split the servo mount off the frame, and a test-print set to go on a bed
    The pan cradle is its own part now. Left in the frame it hung off the back
    at a different height facing a different way, so there was no face to lay
    the frame on; taken off, the frame's whole back is one 1542 mm2 plane and
    the cradle is a flat plate.
    The screws go in level, not up. Driving one up from underneath needs a hole
    and a counterbore through the plate's bottom face, and that face is the one
    the part prints on. Level screws leave it untouched - so the tilt webs went
    from 3.0 to 5.5 wide to give the M2 something to bite: 9 mm of thread with
    1.9 mm of wall each side, where everywhere else on the back of the frame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
    [RIG_base.stl, RIG_frame.stl, RIG_horn_pan.stl, RIG_horn_tilt.stl, RIG_link.stl, RIG_pins_L.stl, RIG_pins_R.stl, RIG_rod_pan.stl]
2026-08-20 Eyelids: upper pair driven off a third servo, and the whole set to print
    The lids ride the tilt FRAME. It turns about the line through both eye
    centres, so a lid pivoting on that same line sweeps the ball at constant
    radius through the whole of tilt. Hang them off the base and the ball turns
    20 deg under a lid built loose enough to survive the worst angle, so it
    gapes at every other one. Pan does not enter into it: a sphere turning
    about its own centre is the same sphere.
    Each lid pivots on its own stub OUTBOARD of its ball, and the two are tied
    by a plain rod through both cranks - both cranks point the same way, so the
    pins are coaxial and the tie is a shaft, not a linkage. The alternative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
    [LID_horn.stl, LID_mount.stl, LID_rod.stl, LID_tie.stl, LID_up_L.stl, LID_up_R.stl, RIG_base.stl, RIG_frame.stl]
2026-08-20 Fix the lid rod's far eye, and retire the old test-print set
    The far eye was bored Ø5.3, sized for the TIE from when the tie was the
    drive point. The drive moved to a Ø3 crank pin on the left hub and the bore
    never followed, leaving 1.15 mm of slop per side - enough that the mouth
    read visibly wider than every other snap eye on the rig. All of them are
    Ø3.3 on a Ø3.0 pin with a 2.75 mouth now.
    "test prints/" is deleted. It held the set from before the lids existed:
    older frame, no lid brackets, fork arm still 12 mm wide. Keeping a stale
    folder of STLs beside a current one is the exact thing the .gitignore note
    warns about, and it says two parts were printed from a superseded file last
    t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
    [LID_rod.stl, LID_up_L.stl, LID_up_R.stl, RIG_base.stl, RIG_frame.stl, RIG_horn_pan.stl, RIG_horn_tilt.stl, RIG_link.stl]
2026-08-20 Print and fit sheet for the eye rig
    Fit plate first: two horns and one rod, twenty minutes, testing the two
    fits that can be tested cheaply. HORN_BORE is the only number in the build
    that is a guess rather than a measurement or a derivation - it is a press
    fit onto an MG90S spline I have never had in front of me, and it is
    one-way. Getting it wrong on a small part costs minutes; getting it wrong
    on the frame costs hours.
    Also written down: which six parts want a brim, the one place that needs
    support and why (the tilt shaft bridges 16 mm and that span is the
    bearing), assembly order - eyes go in before anything blocks the fork - and
    the slop each bearing is designed to have, so it can be ju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
2026-08-22 Measure the horn bore, and cut the lid pivot once
    HORN_BORE was 4.7, and the print sheet was honest that it was an estimate of
    the MG90S spline rather than a measurement. It was wrong: 4.7 had to be forced
    on. 5.2 dropped on and spun, so the window is about half a millimetre wide and
    guessing in steps costs a print per guess.
    bore_ladder() prints the whole range at once instead - hub pucks at 4.75 /
    4.85 / 4.95 / 5.05, no arm and no pin, ten minutes on a 60 mm square. Bumps on
    the rim count the size, one for the smallest, so four near-identical discs
    coming off the bed cannot be mixed up. 4.95 is the measured answer in grey PLA
    and the three horns are re-exported to it. It is printer- and f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
    [LID_horn.stl, RIG_horn_pan.stl, RIG_horn_tilt.stl]
2026-08-22 Retire the eye rig to research archive 02
    The rig was printed and assembled on 22 Aug 2026 and cannot be built. Three
    failures, none of them tolerance:
    - RIG_pins cannot pass the fork bore. It is O6.2; the collar that has to go
    through it is O10, and coming the other way the lever sweeps O22.6. Blocked
    both directions. The part needs the fork permanently in the middle of it,
    which only works if it is two pieces.
    - RIG_frame cannot go onto RIG_base. The tilt shaft is one continuous O5 rod
    through a CLOSED O5.2 hole. Threading it out needs 23 mm of axial slide;
    there is 0.50 before a web hits the pillar.
    - LID_tie is a round rod in a round hole and transmits no torque, so blinking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
    [LID_horn.stl, LID_mount.stl, LID_rod.stl, LID_tie.stl, LID_up_L.stl, LID_up_R.stl, RIG_base.stl, RIG_frame.stl]
2026-08-30 Desk bot: fix the servo pockets, joint the shell to the dome, run wires
    Every printed part is now a closed solid. It was not before, and none of
    this was visible in the viewport - the tears were dropped faces at glancing
    intersections, which solid shading draws either side of quite happily.
    The root cause of most of it: _svpocket drew a case box, an ear box and two
    screw pilots into ONE bmesh and handed EXACT a self-intersecting difference
    operand. It cut the outline and silently no-opped inside it. Measured
    consequences, all present and none reported by fits():
    - the top 4.7 mm of EVERY servo case was solid material, both arms and
    the nod, plus both ear tips
    - four cut cylinders l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
    [desktop_bot_v1.blend]
2026-08-30 Desk bot: lift the arm axis clear of the dome's flare
    Sweeping ARM_RANGE for the first time found the arm root buried 6 mm3 in the
    dome at EVERY angle, -20 through +75. Constant, because the hub and the
    flare are both symmetric about that axis - so posing the arm and looking at
    it can never show this, and fits() only ever measured at rest. Only a sweep
    finds it.
    The offender is the jog box's corners, not the hub: sqrt(8^2+8^2) = 11.31 mm
    of envelope about the axis, dipping to z 70.69, where the dome's skin is
    still flaring out at r 93.14 against an arm face at x 91.
    Fixed by raising ARM_AZ 82.0 -> 84.5, NOT by slimming the arm. Two arms were
    already on the printer when this was found, and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
    [desktop_bot_v1.blend]
2026-08-30 Desk bot: stand the servo mounts on the plate instead of on bridges
    First overhang check this file has ever had, and the dome failed it: 35% of
    its area faced downward, and the print-orientation docstring claims it is
    base-down support-free. Two of the offenders are now carried to the parting
    line so they print off the PLATE.
    pan shelf a 166 mm disc arriving 26 mm up in open air, with the servo
    seat dead in the middle where a bridge sags most. A pedestal
    (PED_X/PED_Y/PED_TOP) drops the seat to SPLIT_Z. The shelf's
    remaining span is an anchored 68 mm gap instead of an 83 mm
    cantilever, and the single 14582 mm2 face over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
    [desktop_bot_v1.blend]
2026-08-30 Desk bot: close the nod drive path, and split the yoke so it prints
    The nod joint drove nothing. Every mating surface in it was a plain round
    cylinder - r3.85 shaft in an r4 bore, at the yoke AND at the head, on both
    sides - so the servo turned DB_cplr, DB_cplr turned in a round hole, and the
    head did not move. Nothing was keyed to anything; the head was not even
    rotationally located, it was a ball hanging on two slip pins.
    It looked right in the viewport because build() parented DB_cplr to E_nod,
    so pose() swung the coupler along with the head. The rig was asserting a fix
    the geometry did not have, and fits() measured the clearances and passed them,
    because clearance answers the same fo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
    [desk_bot.py]
2026-08-31 Document desk bot servo channel map
2026-08-31 Node: bind the listener on IPv6 as well as IPv4
    The bench laptop and the Pi associate with the same access point but get
    addresses from two different DHCP scopes, 10.0.0.0/24 and 192.168.1.0/24,
    and neither router routes between them. IPv6 crosses that gap — both
    machines sit in one 2601:98d:c07c:4a60::/64 — but the node bound
    "0.0.0.0", so port 8765 refused every IPv6 connection while SSH on the
    same host answered fine.
    Binding None instead of "0.0.0.0" listens on both families.
    Claude-Session: https://claude.ai/code/session_01MMtFWExttNkSs5LLnLGxCf
    [server.py]
2026-09-01 Log where the audio goes instead of discarding the evidence
    A greeting of roughly three seconds reached the speaker as about 0.44
    seconds of frames, with ALSA in XRUN. Nothing in the pipeline could say
    where the rest went, because aplay's stderr went to DEVNULL and neither
    end counted bytes.
    The node now keeps aplay's stderr and logs it, reports roughly once per
    second of audio fed to the speaker, and prints mic and speaker totals
    when the brain disconnects. The brain reports how much it released once
    the model stops generating, and how much queued speech an interruption
    drops. Comparing the two totals says whether audio is lost in the brain,
    on the wire, or inside ALSA.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
2026-09-01 Arms that gesture with the speech
    Motion is driven from the envelope of each chunk as PacedPlayback releases
    it, which is what its own docstring asked for: the model finishes
    generating a response about ten times sooner than the speaker finishes
    playing it, so arms driven from response.output_audio.delta would gesture
    through a sentence the head has not said yet and then hold still while it
    keeps talking. Releasing a chunk is the one moment the audio and the wall
    clock agree.
    Pose frames travel as text on the socket already carrying the audio, so a
    gesture cannot drift against the speech it belongs to.
    The brain shapes the motion; the node enforces it. arms.py owns the range
    clamp, the sle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
    [arm_bench.py, arms.py, server.py, test_arms.py, test_control.py]
2026-09-01 Give the arm bench somewhere to put what it finds
    Codex calibrated the channel map electrically and confirmed both signs,
    but the remaining work - the neutral trim after the horns were re-indexed,
    and US_PER_DEG, which has never been measured on this mechanism - had
    nowhere to live. Arms.trim started at zero every run and the bench could
    change it but not record it, so any trim discovered at the bench died with
    the process.
    TRIM is now a module constant that Arms copies, and the bench prints it
    back as source with `save`. US_PER_DEG is marked as the nominal figure it
    actually is, and `calc` derives the real one from two pulses and a
    protractor.
    `pulse` drives a raw microsecond value for th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
2026-09-01 Record neck servo calibration
2026-09-02 Hold the NeoPixel rings in, and open the eyes to let them out
    The eyes were walled in. A ray fired from behind the left one hit solid
    PLA at y 30.7: 1.3 mm left across the front of the bore and inherited as
    "the diffuser", which it only is if the plate is printed in something
    that passes light. They are open now at O35.5 - a 12B's 5050s sit on a
    O30.5 pitch and are 5 square, so they reach O35.0 and anything tighter
    clips them.
    Nothing held a ring in either. DB_eye_holder is an annulus with a raised
    land that bears on the PCB's outer rim all the way round: even pressure,
    a light seal, and the one band on the back of a 12B guaranteed to have
    no solder on it. Everything inboard of O32.4 is ope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
    [desktop_bot_v1.blend]
2026-09-02 Make the eye case a cup the NeoPixel actually goes into
    DB_eye_holder was a washer: a O40 disc with a O32.4 hole through the middle.
    A O36.8 ring cannot go into that at any tolerance, and it was never meant to
    - the ring sat in a pocket in DB_face and the washer only trapped it from
    behind. But it is disc shaped and eye sized and it shipped as an STL, so it
    got tried, and nothing about it said "print the whole face plate first".
    DB_eye_case is a cup. The ring drops in from the BACK, springs past three
    barbs and seats LEDs-first on a flange at the front, held with no face plate
    and no screws - so an eye can be wired and lit on a bench.
    Nothing is dimensioned to a nominal any more. Adafru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
    [desk_bot.py]
2026-09-03 docs: record verified head servo motion
2026-09-03 docs: add NeoPixel eye wiring map
2026-09-03 Give the desk bot a face: eyes that feel, and a head that follows
    The eyes and the head now move with the conversation. Four axes are driven
    where two were, and 24 NeoPixels are driven where none were.
    THE EYES
    Two Ring 12B boards on GPIO13, rendered on the Pi at 40 Hz by
    humalien_node/pixels.py. Eleven moods on a purple palette - idle, listening,
    thinking, speaking, excited, happy, curious, surprised, confused, sleepy,
    off - plus a blink the node does on its own every few seconds, which does
    more for looking alive than any single mood.
    The brain sends a mood and a loudness, never pixels. Rendered frames would
    put 40 messages a second of pixel data next to the speech on the same socket
    and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
2026-09-04 Pin the NeoPixel driver, with its permissions and its licence
    The eyes imported a package that was never in requirements.txt. A fresh Pi
    would have pulled, run, logged "No NeoPixels, running blind-faced" and given
    no hint why.
    Two things about it that are not obvious from the import:
    * It drives the pixels over PIO, so it needs /dev/pio0 rather than plain
    GPIO access, and that device is root-owned until a udev rule says
    otherwise. The rule is in requirements.txt and NEOPIXEL_MAP.md.
    * It is GPL-2.0-only, where everything else here is permissive. That is a
    commercial decision, not a technical one, so it is flagged rather than
    quietly taken. If it goes the other way the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
2026-09-04 Calm the eyes down, keep them purple, and stop a quote killing the robot
    Three things, one of them a crash.
    THE CRASH
    A transcript came back with a smart quote, Windows' cp1252 console could not
    encode it, and UnicodeEncodeError propagated out of the event loop and took
    the whole session down mid-conversation. Nothing the microphone hears should
    be able to do that. stdout and stderr are now UTF-8 with errors="replace".
    ONE HUE
    The palette travelled to cyan for listening and magenta for excitement, and
    the eyes stopped reading as one product - they read as a novelty light.
    Everything now sits on a single violet ramp: EMBER, DEEP, PURPLE, PALE,
    FLARE. Brightness, saturation and how much of t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
    [pixels.py, test_pixels.py]
2026-09-04 Apply the head rates that were actually walked on the robot
    The runtime rates here were 18 and 10 deg/s - chosen to be obviously safe
    rather than to be right, and flagged at the time as the one thing never
    observed on the mechanism. They have now been walked up on the bench in
    stages and accepted at 144 deg/s pan and 108 nod, with the head watched
    through nod 0 -> -2 -> +5 -> 0 and pan 0 -> -5 -> +5 -> 0 at the final
    profile.
    Pan now crosses its whole range in about 0.5 s where it took 1.9, and nod in
    0.9 s where it took 4.7.
    The accelerations are 398 and 237, and they are deliberately not round. A
    flat 80% increase on the accelerations that matched the approved speeds -
    450 and 324 - FAIL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
    [arms.py]
2026-09-04 Say when the head is following somebody
    Face tracking has been on by default since it was written and produced no
    output at all, so the only way to tell whether it was working was to watch
    the robot and guess. It now says when it picks somebody up, when it switches,
    when it glances at somebody else, and when it gives up - on changes only,
    because every frame would bury the rest of the log.
    Claude-Session: https://claude.ai/code/session_013w4UQRzwiPBMUz3nEiH1Qf
2026-09-04 repo cleanup 2
    [desktop_bot_v1.blend]
2026-09-05 Stop a Pi status message from overwriting the mute
    Crashed a second after connecting, on the first node_status the Pi sends.
    That handler already had a local called `state` for the field of the same
    name in the message, and yesterday's sleep work added a `state` parameter
    to the same function for the ConversationState. The Pi saying "ready"
    rebound it to that string, and the next chunk of audio asked "ready"
    whether it was asleep.
    The local is the one that had to move; ConversationState is what the rest
    of the loop means by state. Renamed to node_state.
    Covered by pumping a node_status message and then audio through
    _pump_microphone, which reproduces the AttributeError exactly when the
    re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
2026-09-07 Look through the Arducam, and only fall back to the webcam without one
    The camera was an index in .env, and indices move. Unplug the Arducam and
    it is gone; plug anything else in and everything after it shifts by one.
    HUMALIEN_CAMERA=0 meant the Arducam on the bench where it was written and
    the laptop's built-in webcam here, with nothing in the logs to say so -
    Humalien just quietly starts seeing the wrong room.
    So pick by name instead. camera.py reads the device names the platform
    already knows (pygrabber's DirectShow list on Windows, /dev/v4l/by-id on
    Linux), takes the Arducam whenever it is attached, and keeps everything
    else behind it as the fallback for when it is not. A listed but bus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
2026-09-07 Use the whole sensor: 1280x800, and the backend that can deliver it
    The OV9782 is a 1280x800 global-shutter sensor and was coming up at its
    640x480 default, so recognition was running on a quarter of the frame.
    Eyes now asks for the full size.
    Asking is not enough on Windows. DirectShow will not move this camera off
    YUY2 - setting MJPG through it is accepted and ignored - and raw frames at
    1280x800 do not fit down USB 2: it manages 10.7 fps, under the capture
    loop's own 12.5 Hz. Media Foundation gets 30.7 fps of unique frames at the
    same size, so cameras are opened with MSMF first and DirectShow second.
    DirectShow still supplies the names and the index they belong to, and
    stays as the fallb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
2026-09-07 Tell Tubby what it is, not just how to talk
    persona.md said plenty about how Tubby speaks and nothing about what it IS,
    so the model fell back on what a language model believes about itself.
    Asked about controlling a robot it is being built to control, it said it
    was "just your chatty camera-eyed friend", and said it three more ways
    while the person who writes its code told it otherwise. It was, at the
    time, following that person's face with its head.
    No firmer tone fixes that. Nothing had contradicted the model's own prior,
    so the prior won.
    system_prompt.py builds the session instructions from what is true of this
    run: identity, whether the Pi answered, which camera came up, the tools th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
2026-09-07 Add a way to remove somebody from Humalien entirely
    Asked to delete a child's photos, there was no way to delete anything and
    no clear answer about what was being held. Both are worth fixing.
    There are no photographs - nothing writes an image anywhere, a frame is
    encoded in memory for the vision model and dropped. What persists is face
    embeddings: 128 numbers per stored view, not a picture and not reversible
    into one, but an identifier for a specific person, which is reason enough
    to be able to delete it on request.
    forget_person.py lists who is held and how much of them, and deletes one
    person with their faces, facts and memories in one go. It takes an id
    rather than a name, because names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
2026-09-07 More head, more reach, and a gesture that gets bigger when it means it
    THE HEAD TURNS FURTHER
    Runtime pan was +-14.4 degrees, which on a desk reads as a head that does
    not really turn. It is now +-28.8. That is a decision rather than a new
    bench test, and SERVO_MAP.md says so: the only measurement behind it is
    still the 1000-2000 us sweep that did not bind, and this sits 16 degrees
    inside it either side. Not further, because the eye wiring runs up through
    that joint - the limit on pan is the cable, not the servo.
    The speech sway went with it, 9 to 16 degrees, and the beat from 0.38 to
    0.52 Hz. At the old range a 9 degree sway had to share the travel with
    face tracking, and whichever was bi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
2026-09-07 Find the camera on the thread that actually opens it
    The robot kept using the laptop webcam however the Arducam was configured.
    DirectShow is COM, and COM is per-THREAD. Eyes opens its camera inside
    asyncio.to_thread, and on that worker thread nothing had called
    CoInitialize, so enumerating the device names died with "CoInitialize has
    not been called". A bare `except Exception: return []` turned that into no
    cameras found, and no cameras found falls back to plain index 0 - which is
    the built-in webcam, pointing at the ceiling.
    Every check I ran passed, because a script runs on the main thread where
    COM is already up. devtools/list_cameras.py named the Arducam correctly the
    whole time the r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
